21941211/WiLo/README.md

# WiLo
Full documentation of the WiLo (Wireless Logger) LoRa enabled environmental monitoring logger.
