21941211/WiLo/WiLoV2/WiLoV2 Documentation/Source/Board_Map.odp

USB-IN

POWER SWITCH

SD CARD

BATT

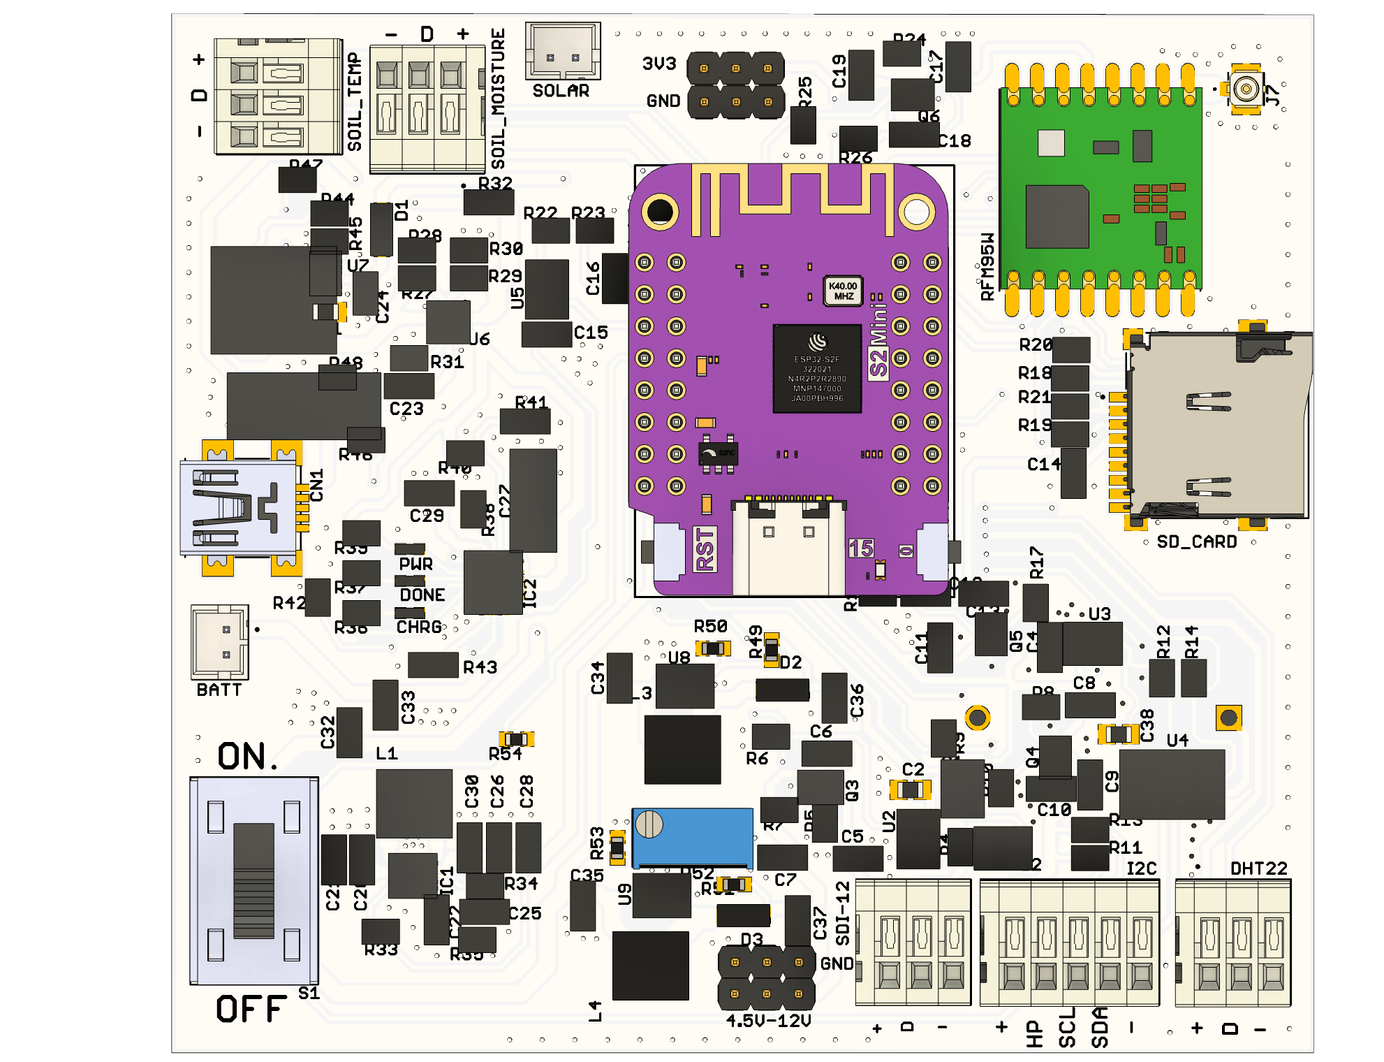
[picture p2: figure]

PORT 1

PORT 2

SOLAR

PWR 1

PORT 3

PORT 4

PORT 5

PWR 2
