21941211/WiLo/DigiDendro - I2C Digitised Dendrometer/PCB Layout/DigiDendroBottom.png

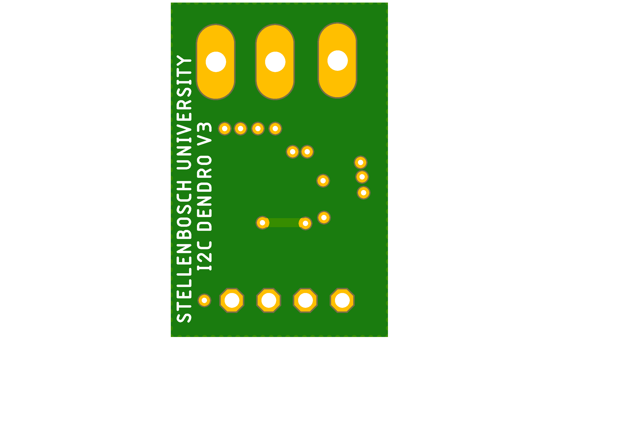
DigiDendro - I2C Digitised Dendrometer/PCB Layout/DigiDendroBottom.png
