21941211/WiLo/DigiDendro - I2C Digitised Dendrometer/PCB Layout/DigiDendroTop.png

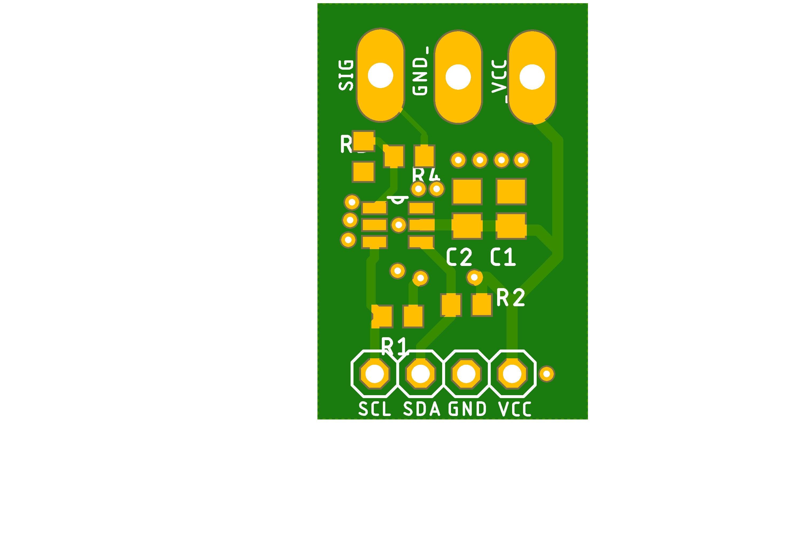
DigiDendro - I2C Digitised Dendrometer/PCB Layout/DigiDendroTop.png
