21941211/WiLo/SU_Forestry_SapFlow/Directions_for_mounting.png

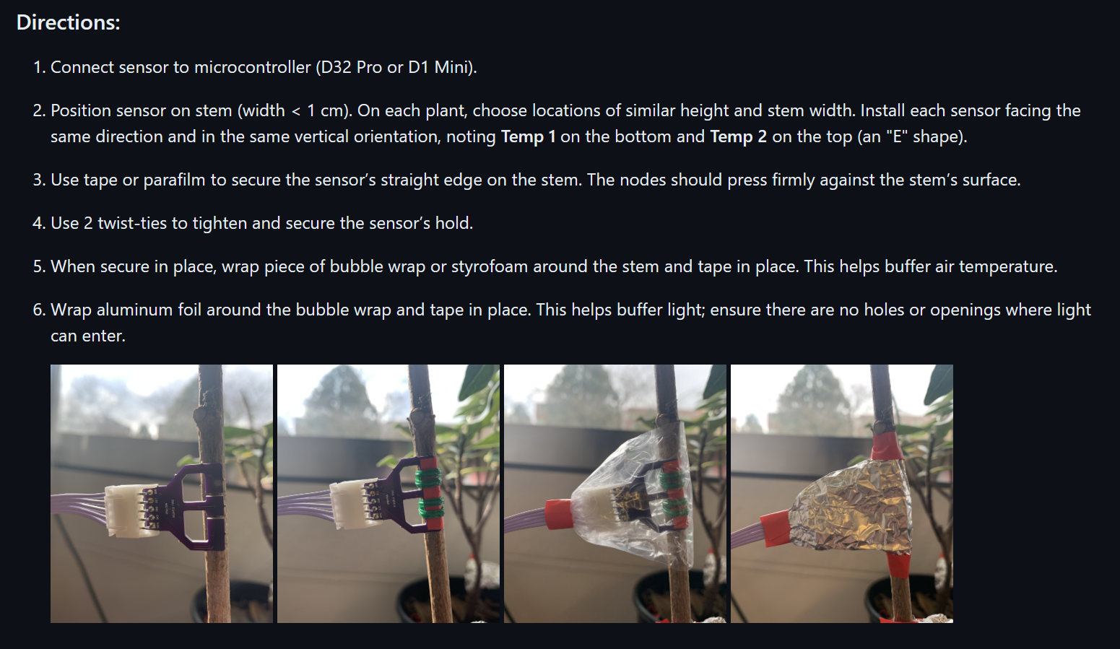
SU_Forestry_SapFlow/Directions_for_mounting.png
