21941211/WiLo/SU_Forestry_SapFlow/dotmote_labs/sapflow-master/docs/sapflow_gauge.png

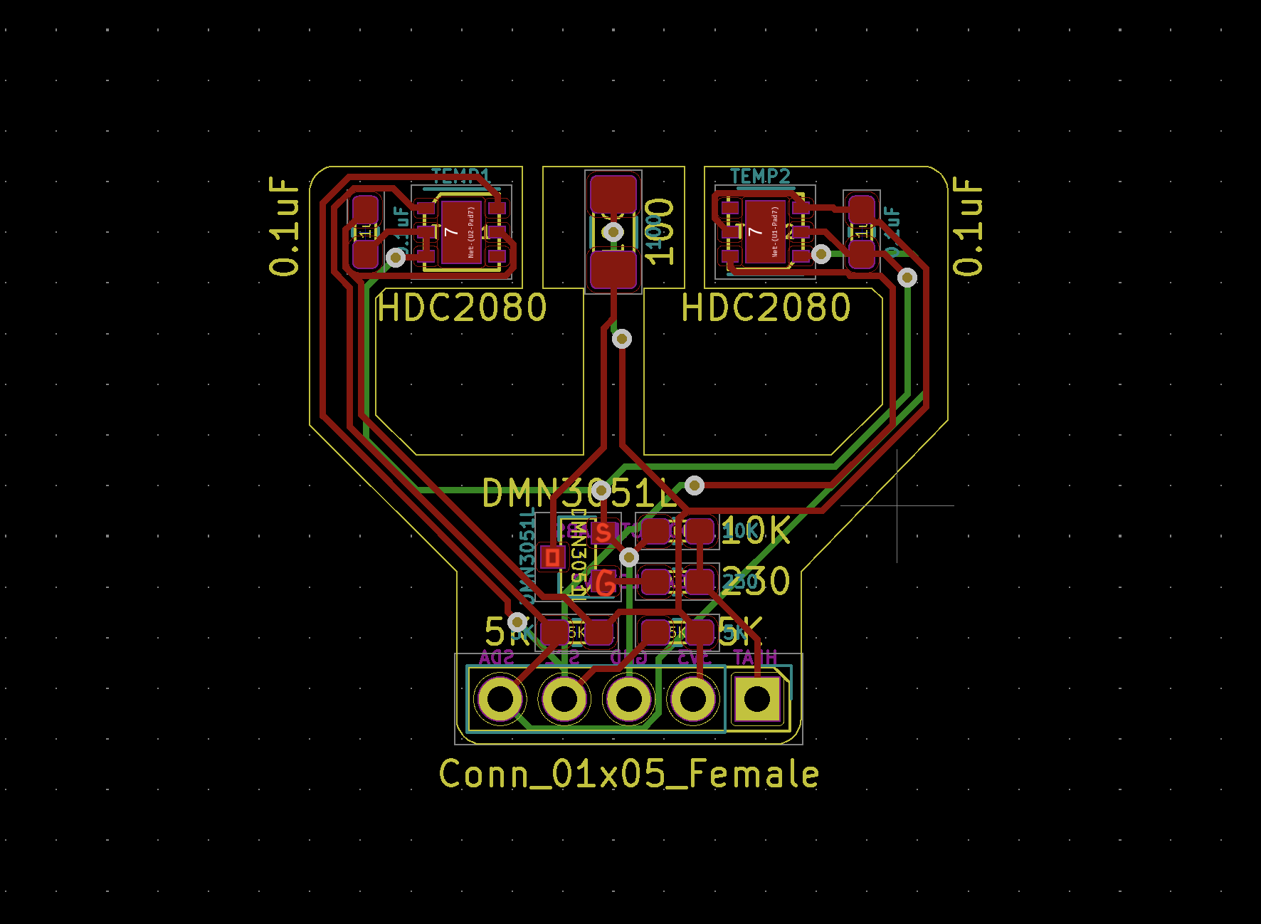
SU_Forestry_SapFlow/dotmote_labs/sapflow-master/docs/sapflow_gauge.png
