21941211/WiLo/WiLoV2/WiLoV2 Documentation/Source/PCB_Bottom.png

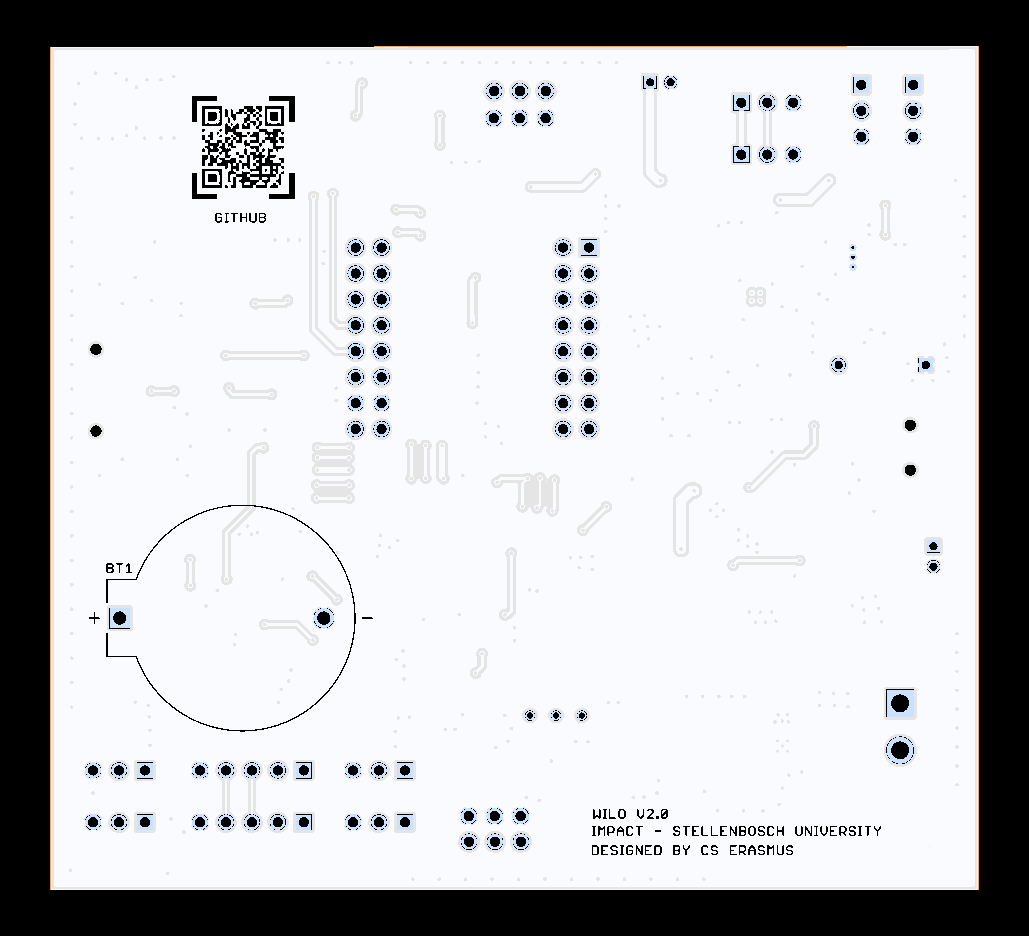
WiLoV2/WiLoV2 Documentation/Source/PCB_Bottom.png
