21941211/WiLo/WiLoV2/WiLoV2 Documentation/Source/WiLoV2_No_MCU.png

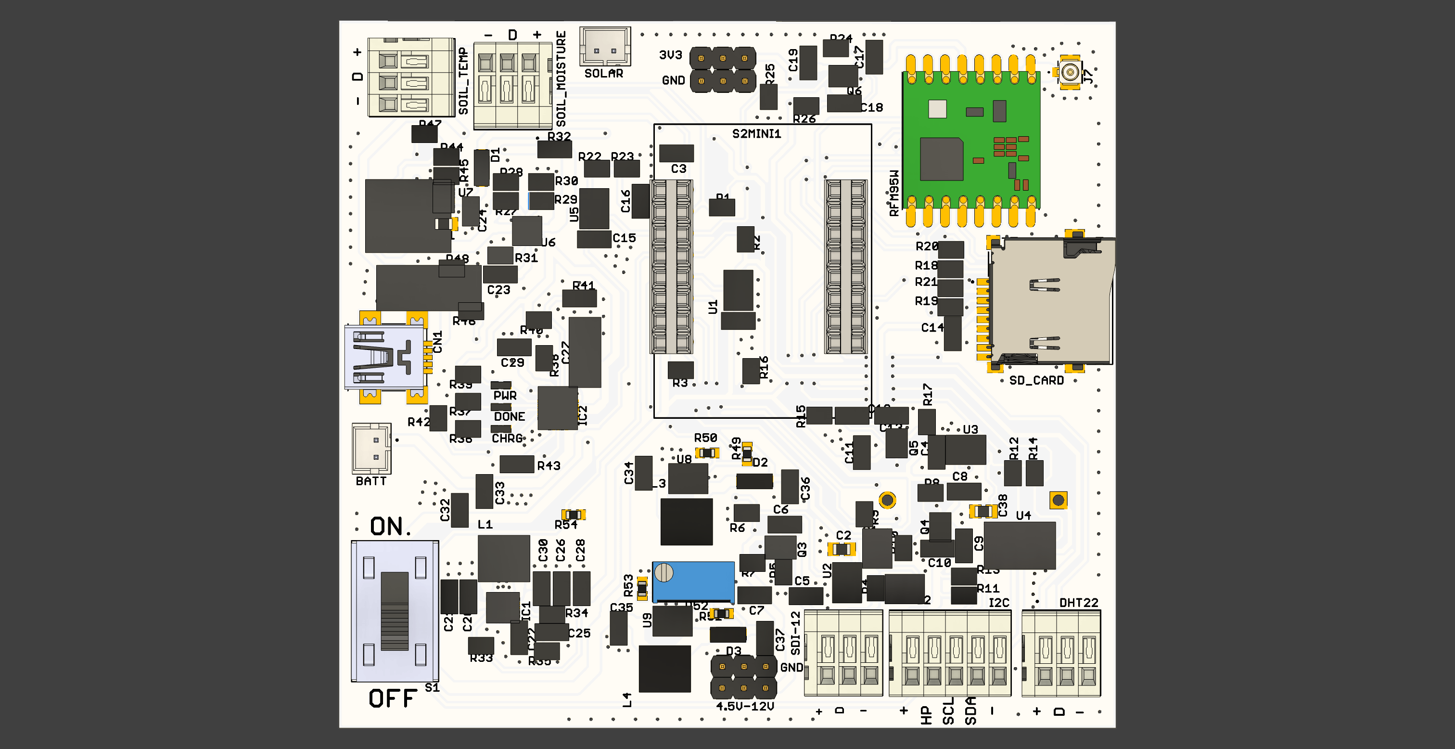
WiLoV2/WiLoV2 Documentation/Source/WiLoV2_No_MCU.png
