21941211/WiLo/SU_Forestry_SapFlow/BOM and Gerber/BOM_SapFlow.xlsx

 |  |  | xxxx xxxx xxxxx xxPCS BOM
Item # | *Designator | *Qty | Manufacturer | *Mfg Part # | Description / Value | *Package/Footprint | Type | Your Instructions / Notes
1 | 0.1uF, 0.1uF | 2 | Samsung Electro Mechanics | CL10B104KB8NNNC | 0.1 uF Capacitor (0603 Package) | 0603 | SMD | The same designator is used for the left and right of the pcb | Link (https://www.digikey.com/product-detail/en/samsung-electro-mechanics/CL10B104KB8NNNC/1276-1000-1-ND/3889086)
2 | DMN3051L | 1 | Diodes | DMN3051L-7 | DMN3051L-7 Logic Level Mosfet (SOT23 Package) | SOT23 | DNS | Only one possible orientation | Link (https://www.digikey.com/product-detail/en/diodes-incorporated/DMN3051L-7/DMN3051LDICT-ND/1964754)
4 | 5K, 5K | 2 | TE Connectivity Passive Product | CRGP0603F5K6 | 5K Ohm Resistor (0603 Package) | 0603 | SMD | The same designator is used for the left and right of the pcb | Link (https://www.digikey.com/product-detail/en/te-connectivity-passive-product/CRGP0603F5K6/A130425CT-ND/8578257)
5 | 230 | 1 | Panasonic | ERJ-3EKF2700V | 270 Ohm Resistor (0603 Package) | 0603 | SMD |  | Link (https://www.digikey.com/product-detail/en/panasonic-electronic-components/ERJ-3EKF2700V/P270HCT-ND/1746751)
6 | 10K | 1 | Stackpole Electronics Inc | RNCP0603FTD10K0 | 10K Ohm Resistor (0603 Package) | 0603 | SMD |  | Link (https://www.digikey.com/product-detail/en/stackpole-electronics-inc/RNCP0603FTD10K0/RNCP0603FTD10K0CT-ND/2240478)
7 | TEMP1,TEMP2 | 2 | Texas Instruments | HDC2080DMBT | HDC2080 Temperature & Humidity Sensor (6-WSON Package) | 6-WSON | SMD | Align package corner (underneath) with corner on footprint (see note 1 below) | Link (https://www.digikey.com/product-detail/en/texas-instruments/HDC2080DMBT/296-49482-1-ND/9360700)
8 | 100 | 1 | Stackpole Electronics Inc | RNCP1206FTD100R | 100 Ohm Resistor (1206 Package) | 1206 | SMD |  | Link (https://www.digikey.com/product-detail/en/stackpole-electronics-inc/RNCP1206FTD100R/RNCP1206FTD100RCT-ND/2240655)
Need a quick and accurante quote? Need an efficient production? Please read SMT Ordering Necessary Files & Info in 1 minute. Thank you very much! (https://www.pcbway.com/smt_ordering_guide.html)
Click for Instructions on How to Create a BOM (https://www.pcbway.com/blog/PCB_Assembly/How_to_Build_a_BOM__Bill_Of_Materials_.html)
 |  |  |  |  | Note 1
