21941211/WiLo/SU_Forestry_SapFlow/BOM and Gerber/Copy of T-1N8W740357A-250sets-BOM_SapFlow(2025-02-02).xls

PCBWay Bom Quotation, Product No.:T-1N8W740357A
Item # | *Designator | *Qty | Manufacturer | *Mfg Part # | Description / Value | *Package/Footprint | Mounting Type | Your Instructions / Notes | *Unit Price(250 sets) | *Total | *Delivery Time | *PCBWay Note | Customer Reply | PCBWay Update
1 | 0.1uF, 0.1uF | 2 | Samsung Electro Mechanics | CL10B104KB8NNNC | 0.1 uF Capacitor (0603 Package) | 0603 | SMD | The same designator is used for the left and right of the pcb『 』Link | $0.004 | $2.000 |  | Reference designator [0.1uF] is duplicated, please confirm. | Correct, both designators have a 0.1uF Cap
2 | DMN3051L | 1 | Diodes | DMN3051L-7 | DMN3051L-7 Logic Level Mosfet (SOT23 Package) | SOT23 | SMD | Only one possible orientation『 』Link |  |  |  | [DNP不要贴]; | Please add, should be soldered onto the boards.
3 | 5.6K, 5.6K | 2 | TE Connectivity Passive Product | CRGP0603F5K6 | 5K Ohm Resistor (0603 Package) | 0603 | SMD | The same designator is used for the left and right of the pcb『 』Link | $0.009 | $4.500 |  | The correct resistance value for the listed Part Number [CRGP0603F5K6] is indeed [5.6], not [5KΩ].Please confirm.; Reference designator [5K] is duplicated, please confirm. | This is indeed correct, 5.6k is fine.
4 | 230 | 1 | Panasonic | ERJ-3EKF2700V | 270 Ohm Resistor (0603 Package) | 0603 | SMD | Link | $0.009 | $2.250
5 | 10K | 1 | Stackpole Electronics Inc | RNCP0603FTD10K0 | 10K Ohm Resistor (0603 Package) | 0603 | SMD | Link | $0.031 | $7.750 | 7-10 Workdays
6 | TEMP1,TEMP2 | 2 | Texas Instruments | HDC2080DMBT | HDC2080 Temperature & Humidity Sensor (6-WSON Package) | 6-WSON | SMD | Align package corner (underneath) with corner on footprint (see note 1 below)『 』Link | $3.401 | $1700.500 | 7-10 Workdays
7 | 100 | 1 | Stackpole Electronics Inc | RNCP1206FTD100R | 100 Ohm Resistor (1206 Package) | 1206 | SMD | Link | $0.041 | $10.250
 |  |  |  |  |  |  |  |  | Component Cost | $1727.25
 |  |  |  |  |  |  |  |  | Assembly Cost | $304.29
 |  |  |  |  |  |  |  |  | PCB Cost | $57.97
 |  |  |  |  |  |  |  |  | V3 Member 3% off | -$10.87
 |  |  |  |  |  |  |  |  | All Total 250 Sets | $2078.64
