21941211/WiLo/3D printing/Fusion 360/PCB Clip/Source/PCB_Mount.FCStd

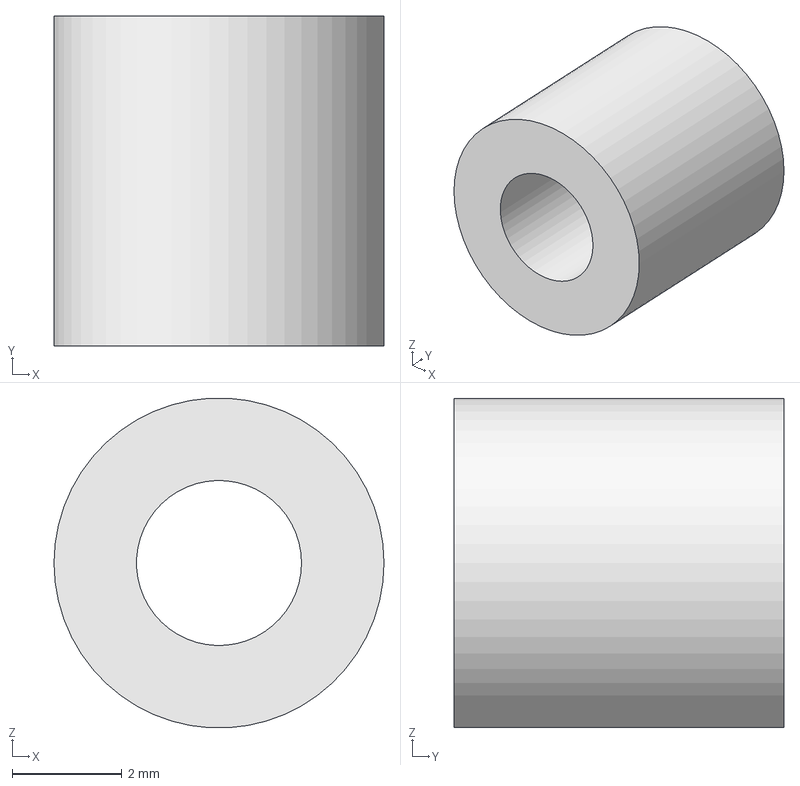
[picture p11: CAD file, 2025-04-16]
3D printing/Fusion 360/PCB Clip/Source/PCB_Mount.FCStd
6.00 x 6.00 x 5.99 mm
