21941211/WiLo/3D printing/STLs/DHT22 Stevenson Screen/Mount.stl

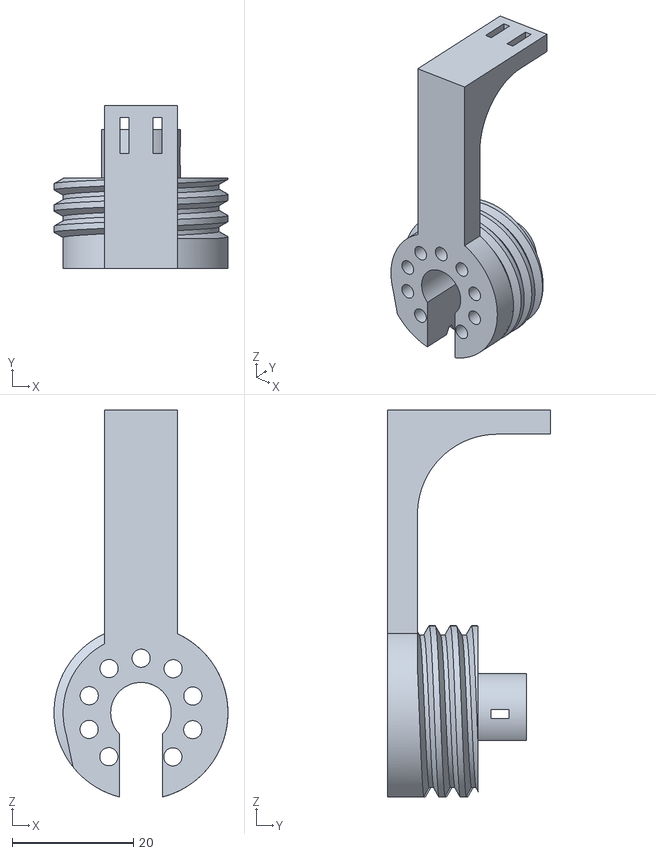
[picture p12: CAD file, 2025-04-16]
3D printing/STLs/DHT22 Stevenson Screen/Mount.stl
28.7 x 27.0 x 63.9
