21941211/WiLo/3D printing/STLs/PCB Clips/PCB Clip Right Side.stl

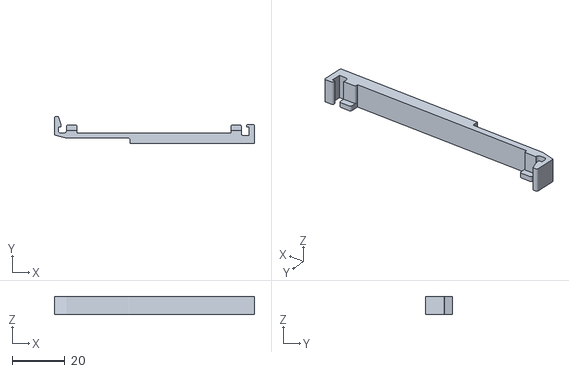
[picture p13: CAD file, 2025-04-16]
3D printing/STLs/PCB Clips/PCB Clip Right Side.stl
75.8 x 10.2 x 7.00
