21941211/WiLo/Battery Charger Files/Power supply and charger module hub bracket.stl

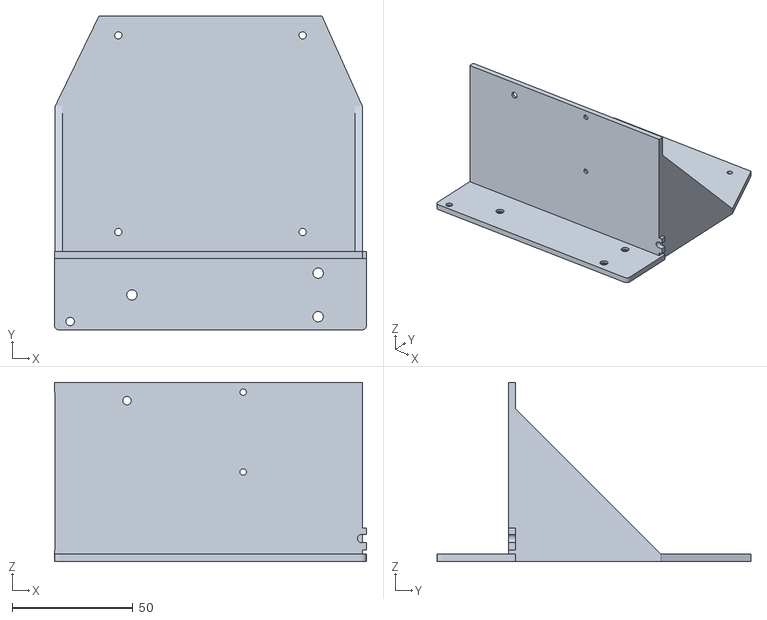
[picture p14: CAD file, 2025-07-03]
Battery Charger Files/Power supply and charger module hub bracket.stl
129.0 x 129.8 x 74.0
