21941211/WiLo/3D printing/STLs/DHT22 Stevenson Screen/Screen.stl

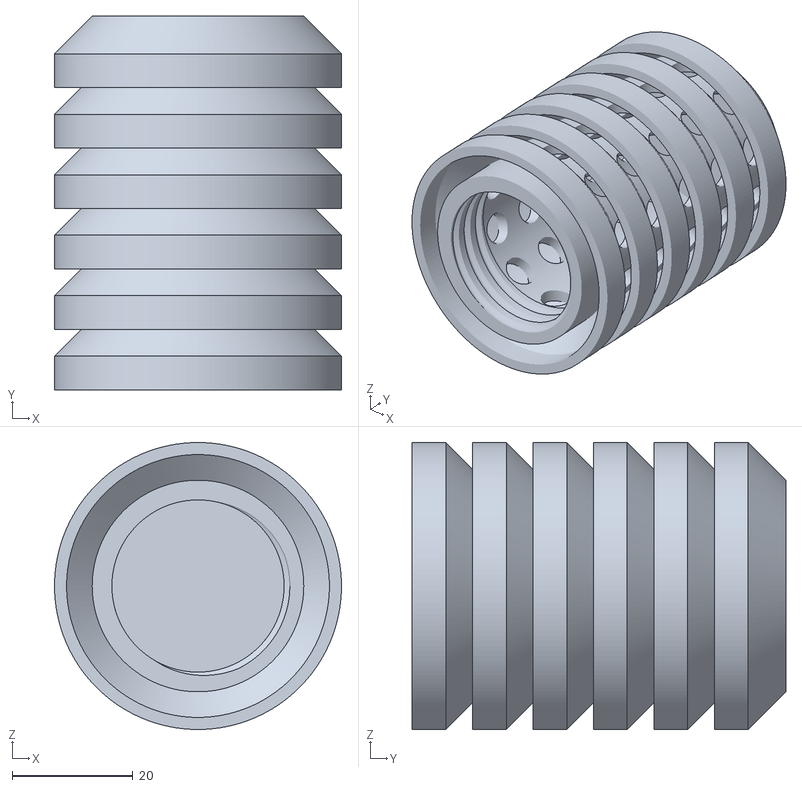
[picture p16: CAD file, 2025-04-16]
3D printing/STLs/DHT22 Stevenson Screen/Screen.stl
47.5 x 61.8 x 47.5
