21941211/WiLo/(list of files, cad)

Other CAD files:
3D printing/Fusion 360/PCB Clip/PCB_CLip_WiLo_V1 v1.f3d
3D printing/Fusion 360/PCB Clip/Source/PCB_Clip v19.f3d
Battery Charger Files/WiLoV2 v2.f3d
