21941211/WiLo/3D printing/STLs/Ball and socket joint for solar panel/README.MD

This is a ball and socket joint that we haven't used for the WiLos yet, but will be a nice addition. Credit to the creator at: https://www.thingiverse.com/thing:67911

Print settings:
    - Material: PETG (Stronger than PLA. PLA+ or ABS might work too.)
    - Infill: 100%
    - Supports: None
    - Print temperature: 235 C
    - Build Plate Temperature: 85 C
    - Layer Height : 0.2mm
