21941211/WiLo/3D printing/Fusion 360/PCB Clip/Source/README.md

# PCB-Mount
A Fusion 360 and FreeCAD project file that contains two bodies to mount PCBs: a simple spacer cylinder for classic screw mounts of PCBs and the RAYDIY's hipster PCB-Clips.

Use with FreeCAD version 0.19.23576 or newer. I had problems with versions prior to this one.

YouTube Video with introduction (in german)
- https://youtu.be/MF4QiW3_oBQ

Blog Article (in german)
- https://raydiy.de/clippen-statt-schrauben-microcontroller-befestigen-mit-pcb-clips/
