21941211/WiLo/SU_Forestry_SapFlow/dotmote_labs/sapflow-master/InstallationSteps_full.md

# Installation Steps
1. [Sensor Installation](#sensorinstallation)
2. [Checklist for D32 Pro (WiFi)](#d32wifi)
3. [Checklist for D32 Pro (Raspberry Pi)](#d32pi)
4. [Checklist for D1 Mini](#d1mini)

-------------------------------

<a href="#top">(Back to top)</a>  

## Sensor Installation                                                  

### Materials: 
* Sensor
* Tape or parafilm
* 2 Twist-ties
* Bubble wrap or styrofoam (~ 5 x 12 cm)
* Aluminum foil (~ 5 x 12 cm)

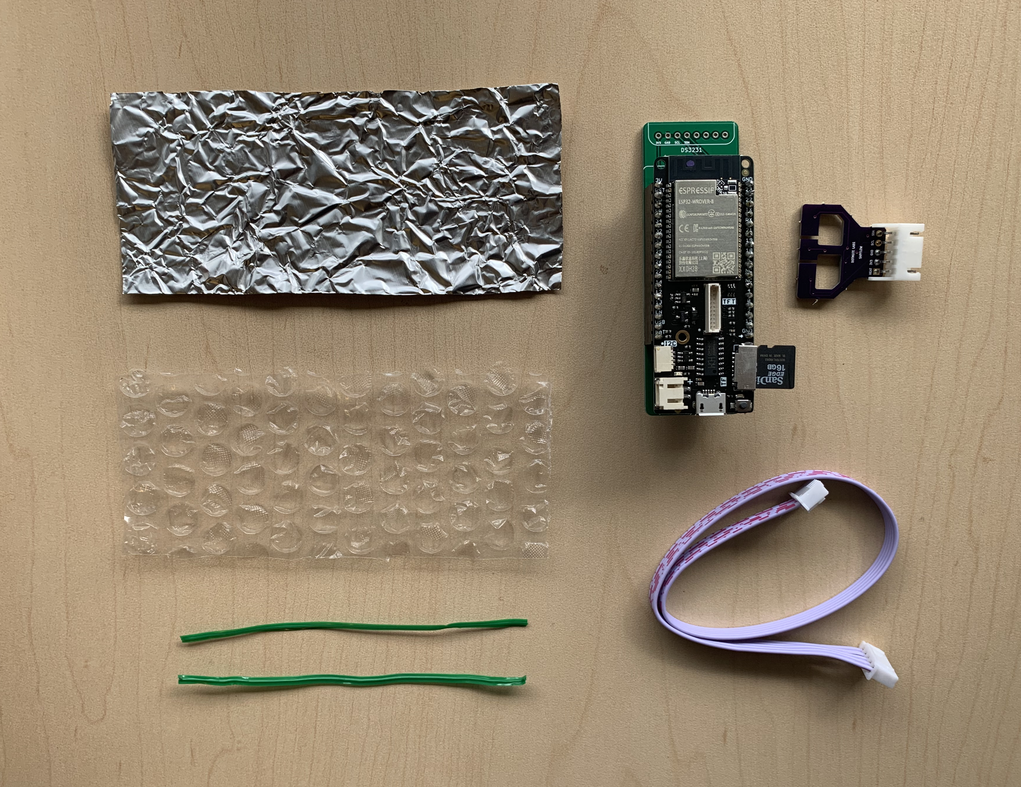
[picture p17: SU_Forestry_SapFlow/dotmote_labs/sapflow-master/docs/InstallationMaterials.png]


### Directions:
1. Connect sensor to microcontroller (D32 Pro or D1 Mini).
2. Position sensor on stem (width < 1 cm). On each plant, choose locations of similar height and stem width. Install each sensor facing the same direction and in the same vertical orientation, noting **Temp 1** on the bottom and **Temp 2** on the top (an "E" shape). 
3. Use tape or parafilm to secure the sensor’s straight edge on the stem. The nodes should press firmly against the stem’s surface. 
4. Use 2 twist-ties to tighten and secure the sensor’s hold.
5. When secure in place, wrap piece of bubble wrap or styrofoam around the stem and tape in place. This helps buffer air temperature.
6. Wrap aluminum foil around the bubble wrap and tape in place. This helps buffer light; ensure there are no holes or openings where light can enter. 

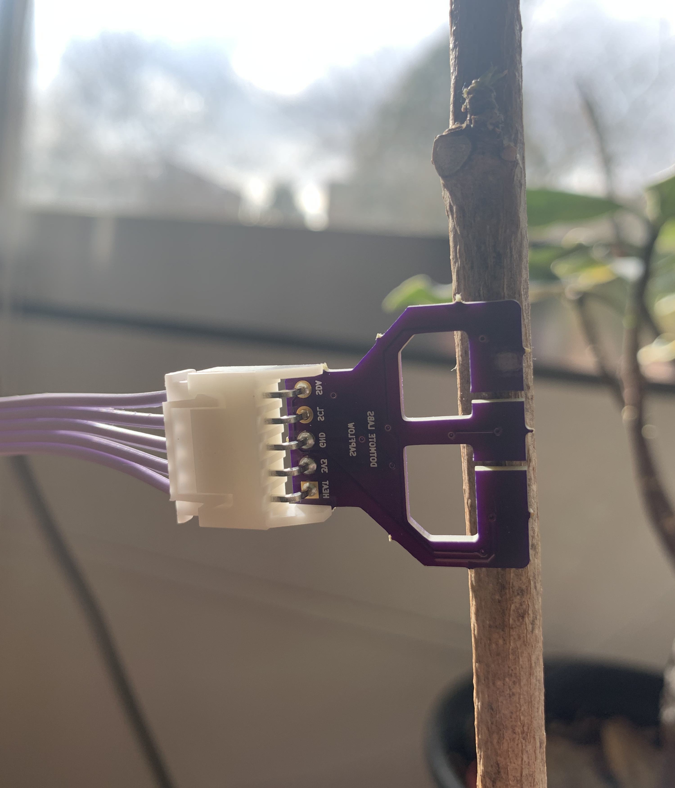
[picture p18: SU_Forestry_SapFlow/dotmote_labs/sapflow-master/docs/InstallationSensor1.png]
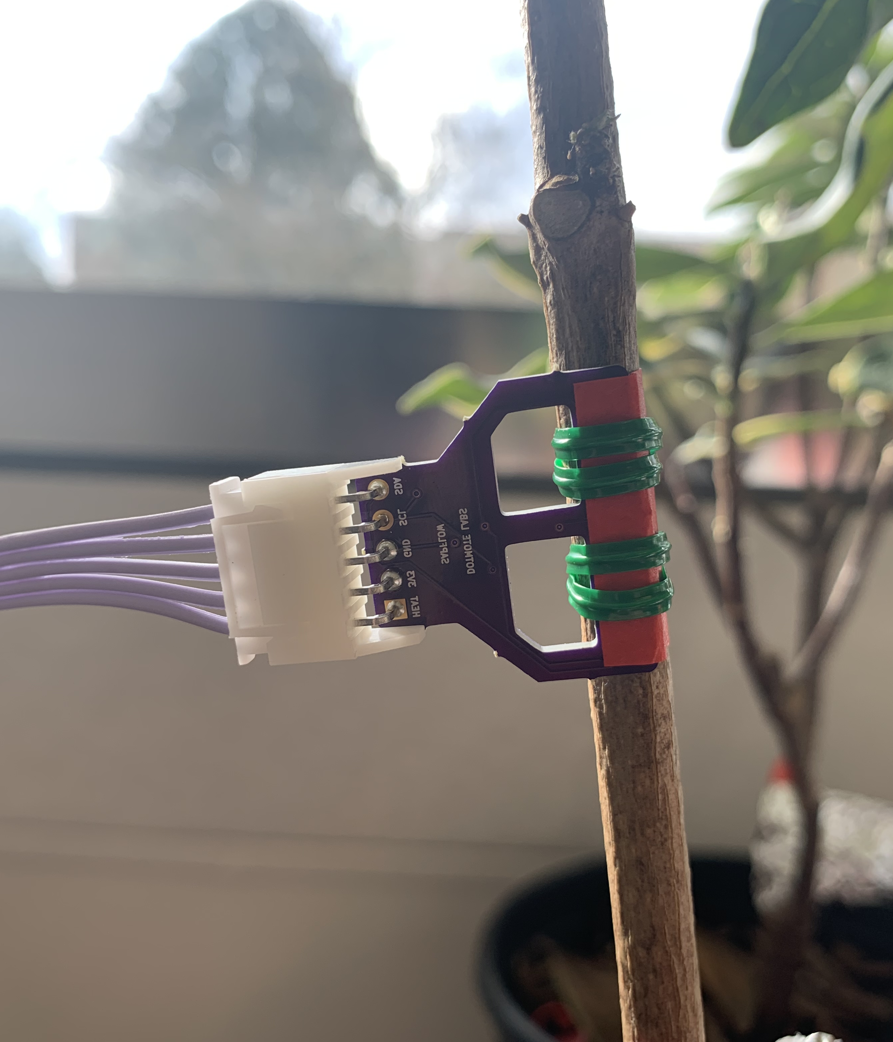
[picture p19: SU_Forestry_SapFlow/dotmote_labs/sapflow-master/docs/InstallationSensor2.png]
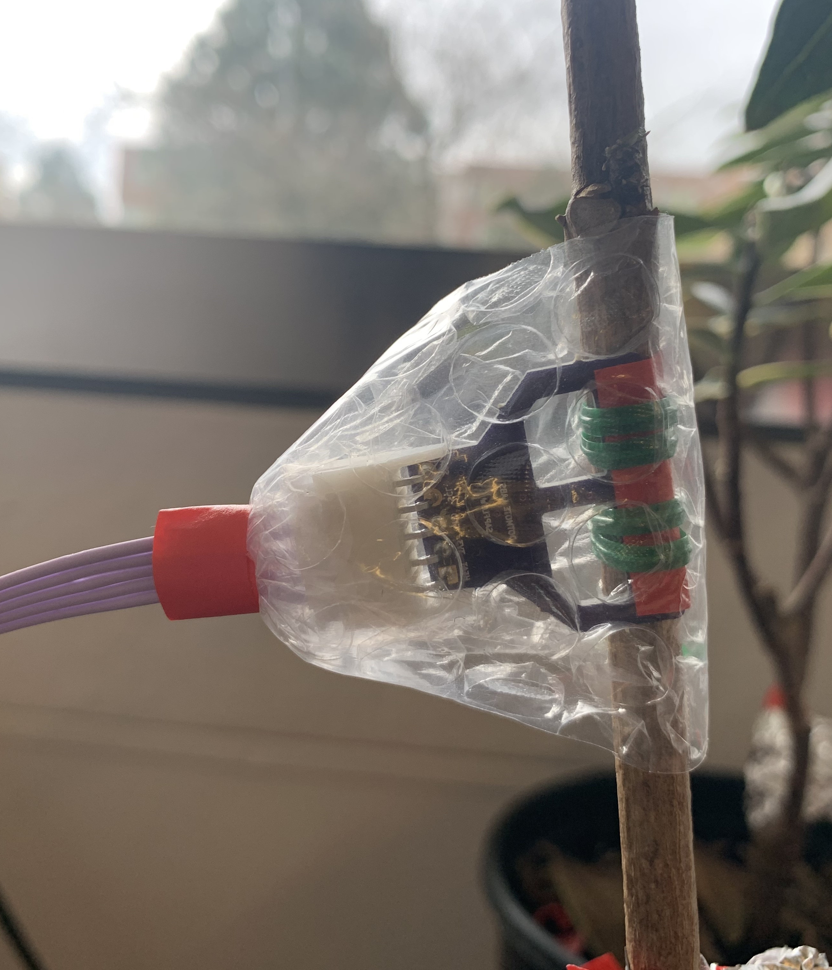
[picture p20: SU_Forestry_SapFlow/dotmote_labs/sapflow-master/docs/InstallationSensor3.png]
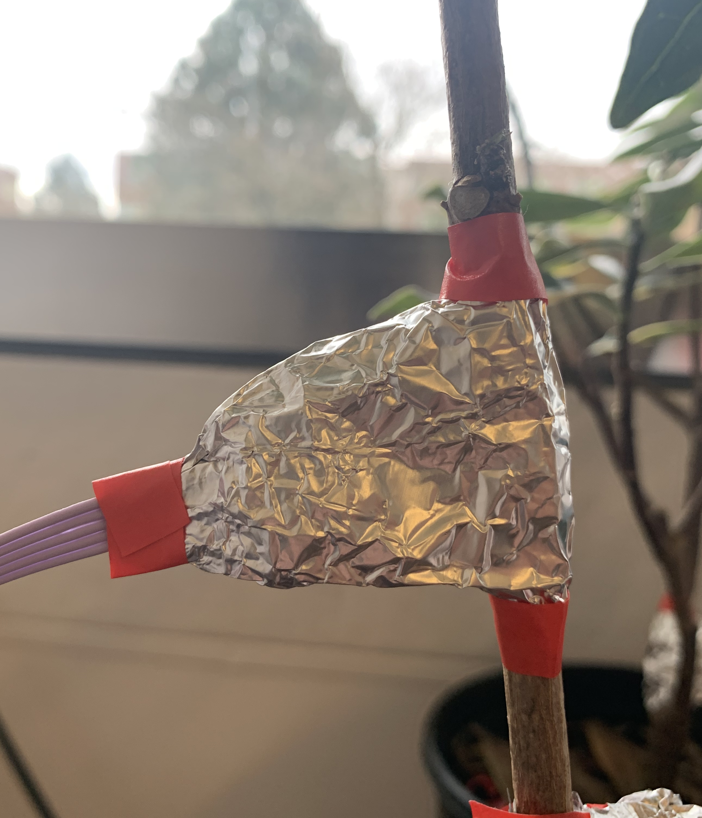
[picture p21: SU_Forestry_SapFlow/dotmote_labs/sapflow-master/docs/InstallationSensor4.png]
      

-------------------------------

<a href="#top">(Back to top)</a> 

## Checklist for D32 Pro (WiFi) 

### Board: [Arduino-ESP32](https://github.com/espressif/arduino-esp32/blob/master/docs/arduino-ide/boards_manager.md)
- [ ] Connect microcontroller via USB.
- [ ] In Arduino, open Preferences and copy release link to Additional Boards Manager URLs. Separate multiple URLs with commas. (Files > Preferences)
- [ ] Open Boards Manager, search **"esp32"** and install. (Tools > Board > Boards Manager)
- [ ] Switch board to **LOLIN D32 PRO**. (Tools > Board)

### Install dependencies:
- [ ] In Library Manager, search and install the following libraries (Tools > Manage Libraries):
    - [Adafruit GFX](https://github.com/adafruit/Adafruit-GFX-Library)
    - [ArduinoJSON](https://arduinojson.org/) by Benoit Blanchon
    - [ESP_DoubleResetDetector](https://github.com/khoih-prog/ESP_DoubleResetDetector) by Khoi Hoang
    - [ESP_WiFiManager](https://github.com/khoih-prog/ESP_WiFiManager) by Khoi Hoang
    - [HDC2080 Arduino Library](https://github.com/lime-labs/HDC2080-Arduino) by Lime Labs
    - [PubSubClient](https://pubsubclient.knolleary.net/) by Nick O'Leary
    - [RTC by Makuna](https://github.com/Makuna/Rtc/wiki) by Michael C. Miller
    - [Time](https://playground.arduino.cc/code/time/) by Michael Margolis
- [ ] These optional libraries can be downloaded online and copied to Arduino Libraries folder in Finder. Comment out applicable lines in script if unused. (In Finder, Arduino > libraries)
    - [LOLIN E-Paper Display Library](https://github.com/wemos/LOLIN_EPD_Library)
    - [WEMOS SHT3x Arduino Library](https://github.com/wemos/WEMOS_SHT3x_Arduino_Library)

### Network settings:
- [ ] Open [D32 Pro script (WiFi)](https://github.com/dotmote/sapflow-usda-6/blob/master/sapflow-usda-6.ino) in Arduino.
- [ ] Verify/Compile and Upload to microcontroller via USB
- [ ] Connect to WiFi: 
    - On phone or computer, select WiFi network **“SAPFLOW_<unique_chip_id>”**. 
    - On next screen, select **“Configuration”**.
    - Select WiFi network, enter password, and select **"Save"**.
    - Wait to connect. “SAPFLOW_<unique_chip_id>” will disappear from network list when complete.
- [ ] NOTES:
    - Once connected, the "SAPFLOW_<unique_chip_id>" network will not reappear when reconnecting to the same network. 
    - If "SAPFLOW_<unique_chip_id>" network does not appear for initial connection, press and hold Reset button on microcontroller for 5 seconds. 
    - The microcontroller might reset itself while attempting to connect to the network.
    
### Check:
- [ ] Operating modes:
    - **Normal:** If microcontroller is successfully connected to the network, the blue LED will be solid only during the heat pulse. Data will be both recorded to the MicroSD card and uploaded online through the dashboard.
    - **Offline:** If microcontroller is in offline mode, the blue LED will blink continuously (~1 blink/second). Data will only be recorded to the MicroSD card.
- [ ] Sign into the [Sapflow Dashboard](https://www.dotmote.com/) to check that data is uploading.

-------------------------------

<a href="#top">(Back to top)</a> 

## Checklist for D32 Pro (Raspberry Pi) 

### Board: [Arduino-ESP32](https://github.com/espressif/arduino-esp32/blob/master/docs/arduino-ide/boards_manager.md)
- [ ] Connect microcontroller via USB.
- [ ] In Arduino, open Preferences and copy release link to Additional Boards Manager URLs. Separate multiple URLs with commas. (Files > Preferences)
- [ ] Open Boards Manager, search **"esp32"** and install. (Tools > Board > Boards Manager)
- [ ] Switch board to **LOLIN D32 PRO**. (Tools > Board)

### Install dependencies:
- [ ] In Library Manager, search and install the following libraries (Tools > Manage Libraries):
    - [Adafruit GFX](https://github.com/adafruit/Adafruit-GFX-Library)
    - [ArduinoJSON](https://arduinojson.org/) by Benoit Blanchon
    - [HDC2080 Arduino Library](https://github.com/lime-labs/HDC2080-Arduino) by Lime Labs
    - [PubSubClient](https://pubsubclient.knolleary.net/) by Nick O'Leary
    - [RTC by Makuna](https://github.com/Makuna/Rtc/wiki) by Michael C. Miller
- [ ] These optional libraries can be downloaded online and copied to Arduino Libraries folder in Finder. Comment out applicable lines in script if unused. (In Finder, Arduino > libraries)
    - [LOLIN E-Paper Display Library](https://github.com/wemos/LOLIN_EPD_Library)
    - [WEMOS SHT3x Arduino Library](https://github.com/wemos/WEMOS_SHT3x_Arduino_Library)
- [ ] NOTE: For PubSubClient, edit PubSubClient.h increase max packet size from **128b to 512b**.
(In Finder, Arduino > libraries > PubSubClient > src > PubSubClient.h > Edit **“#define MQTT_MAX_PACKET_SIZE 512”**)

### Network settings:
- [ ] Open [D32 Pro script (Pi)](https://github.com/dotmote/sapflow/blob/master/software/microcontroller/d32_pro/d32_pro_sapflow_mqtt_sd/d32_pro_sapflow_mqtt_sd.ino) in Arduino. (If microcontroller doesn't have an RTC chip, open [D32 Pro script (no RTC)](https://github.com/dotmote/sapflow/blob/master/software/microcontroller/d32_pro/d32_pro_sapflow_mqtt_noRtc/d32_pro_sapflow_mqtt_noRtc.ino).)
- [ ] ClientID: change `“clientID”`
- [ ] Server/broker IP address: change `“mqtt_server”`
- [ ] Connect to WiFi: enter `“wifi name”` and `“wifi password”`
- [ ] Verify/Compile and Upload to microcontroller via USB

### Check:
- [ ] Open Serial Monitor and check that data is uploading. (Tools > Serial Monitor)
- [ ] Check that Temperatures are not reading negative. If yes, try pressing Reset button on microcontroller several times.
- [ ] Check that data is also transmitting on Raspberry Pi.

-------------------------------

<a href="#top">(Back to top)</a> 

## Checklist for D1 Mini 

### Board: [Arduino-ESP8266](https://github.com/esp8266/Arduino)
- [ ] Connect microcontroller via USB.
- [ ] In Arduino, open Preferences and copy release link (https://arduino.esp8266.com/stable/package_esp8266com_index.json) to Additional Boards Manager URLs. Separate multiple URLs with commas. (Files > Preferences)
- [ ] Open Boards Manager, search **"esp8266"** and install. (Tools > Board > Boards Manager)
- [ ] Switch board to **LOLIN (WEMOS) D1 mini Lite**. (Tools > Board)

### Install dependencies:
- [ ] In Library Manager, search and install the following libraries (Tools > Manage Libraries):
    - [ArduinoJSON](https://arduinojson.org/) by Benoit Blanchon
    - [HDC2080 Arduino Library](https://github.com/lime-labs/HDC2080-Arduino) by Lime Labs
    - [PubSubClient](https://pubsubclient.knolleary.net/) by Nick O'Leary
    - [WiFi Manager](https://github.com/tzapu/WiFiManager) by Tzapu
- [ ] This optional library can be downloaded online and copied to Arduino Libraries folder in Finder. Comment out applicable lines in script if unused. (In Finder, Arduino > libraries)
    - [WEMOS SHT3x Arduino Library](https://github.com/wemos/WEMOS_SHT3x_Arduino_Library)
- [ ] NOTE: For PubSubClient, edit PubSubClient.h increase max packet size from **128b to 512b**.
(In Finder, Arduino > libraries > PubSubClient > src > PubSubClient.h > Edit **“#define MQTT_MAX_PACKET_SIZE 512”**)

### Network settings:
- [ ] Open [D1 Mini script](https://github.com/dotmote/sapflow/blob/master/software/microcontroller/d1_mini/d1_mini_sapflow_mqtt/d1_hdc2080_sapflow_mqtt.ino) in Arduino. 
- [ ] ClientID: change `“clientID”`
- [ ] Server/broker IP address: change `“mqtt_server”`
- [ ] Verify/Compile and Upload to microcontroller via USB
- [ ] Connect to WiFi: 
    - On phone, select WiFi network **“AutoConnectAP”**. 
    - On next screen, select **“Configure WiFi”**.
    - Select WiFi network, enter password, and select **"Save"**.
    - Wait to connect. “AutoConnectAP” will disappear from network list when complete.
- [ ] NOTE: If "AutoConnectAP" network does not appear:
    - Once connected, it will not reappear when reconnecting to the same network.
    - Press and hold Reset button on microcontroller for 5 seconds. 
    - In script, activate `//wifiManager.resetSettings();` to `wifiManager.resetSettings();`. Upload to microcontroller.
    - "AutoConnectAP" network should now appear. Connect through phone.
    - In script, re-comment out `wifiManager.resetSettings();` to `//wifiManager.resetSettings();`. Re-upload to microcontroller.

### Check:
- [ ] Open Serial Monitor and check that data is uploading. (Tools > Serial Monitor)
- [ ] Check that Temperatures are not reading negative. If yes, try pressing Reset button on microcontroller several times.
- [ ] Check that data is also transmitting on Raspberry Pi.
