21941211/WiLo/WiLoV2/WiLoV2 Documentation/Source/OTA_Steps/1. Press_Add_network.jpeg

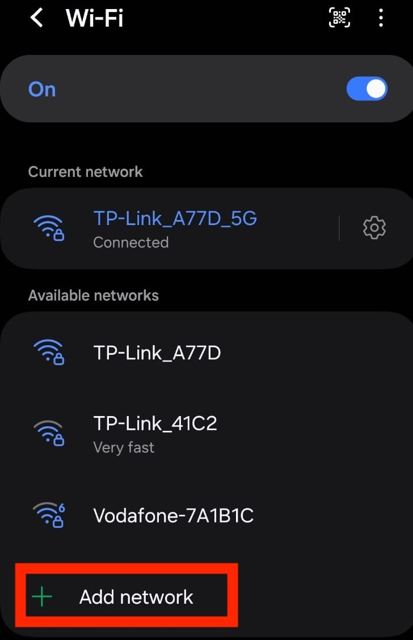
WiLoV2/WiLoV2 Documentation/Source/OTA_Steps/1. Press_Add_network.jpeg
