21941211/WiLo/WiLoV2/WiLoV2 Documentation/Source/OTA_Steps/2. Enter_Details.jpeg

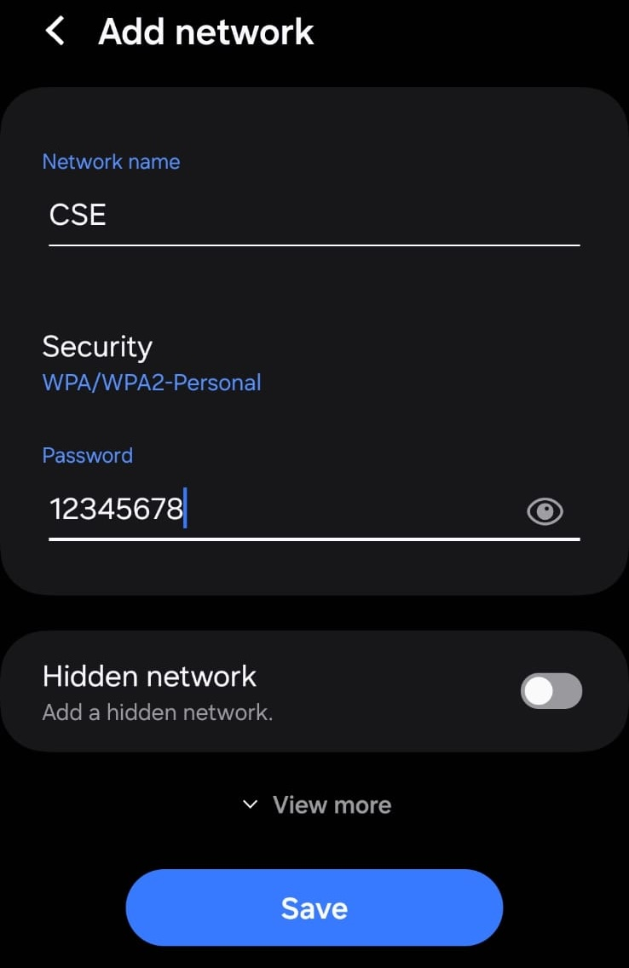
WiLoV2/WiLoV2 Documentation/Source/OTA_Steps/2. Enter_Details.jpeg
