21941211/WiLo/WiLoV2/WiLoV2 Documentation/Source/OTA_Steps/3. Select_Always_Connect.jpeg

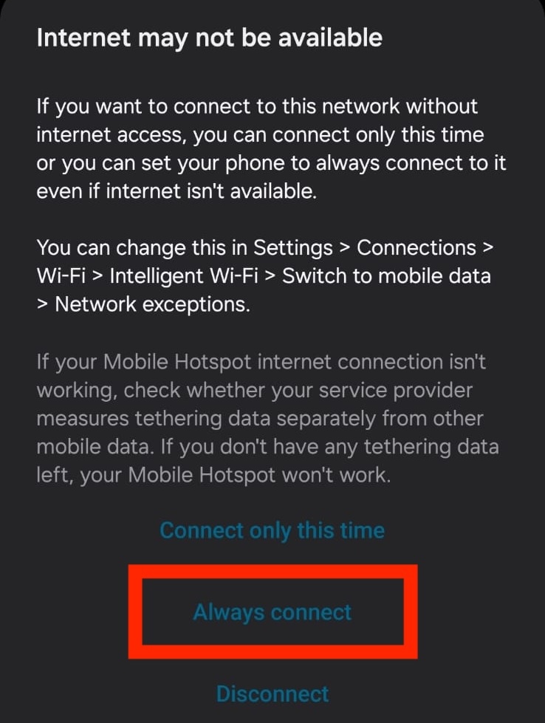
WiLoV2/WiLoV2 Documentation/Source/OTA_Steps/3. Select_Always_Connect.jpeg
