21941211/WiLo/WiLoV2/WiLoV2 Documentation/Source/OTA_Steps/4. After Accepting.jpeg

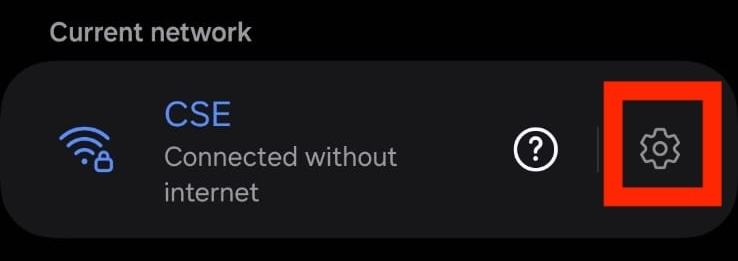
WiLoV2/WiLoV2 Documentation/Source/OTA_Steps/4. After Accepting.jpeg
