21941211/WiLo/WiLoV2/WiLoV2 Documentation/Source/OTA_Steps/5. Click Manage Router.jpeg

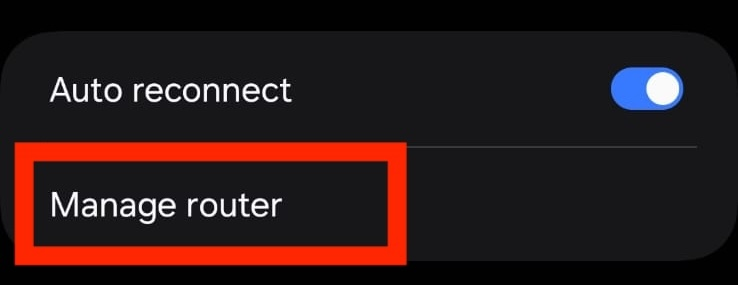
WiLoV2/WiLoV2 Documentation/Source/OTA_Steps/5. Click Manage Router.jpeg
