21941211/WiLo/WiLoV2/WiLoV2 Documentation/Source/OTA_Steps/6. Before Syncing-RTC_WiLo_Homepage.jpeg

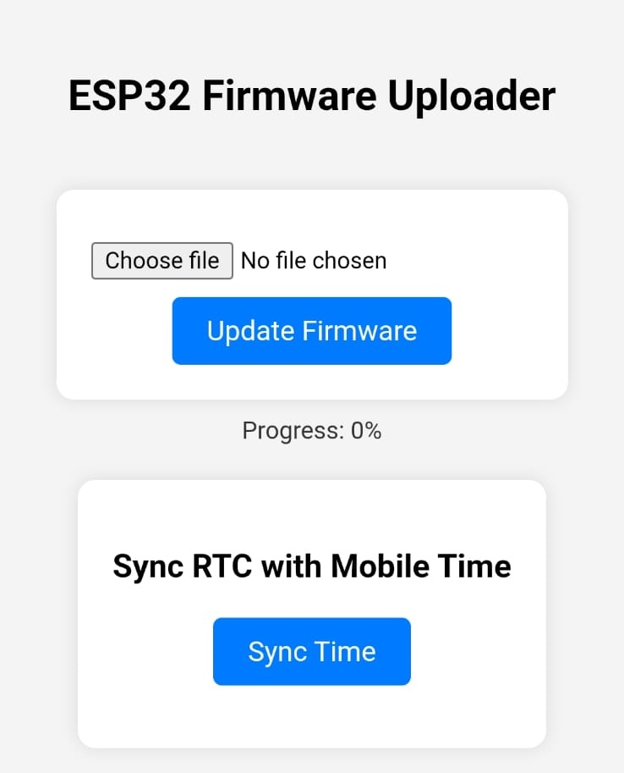
WiLoV2/WiLoV2 Documentation/Source/OTA_Steps/6. Before Syncing-RTC_WiLo_Homepage.jpeg
