21941211/WiLo/WiLoV2/WiLoV2 Documentation/Source/OTA_Steps/7. After_Syncing_RTC.jpeg

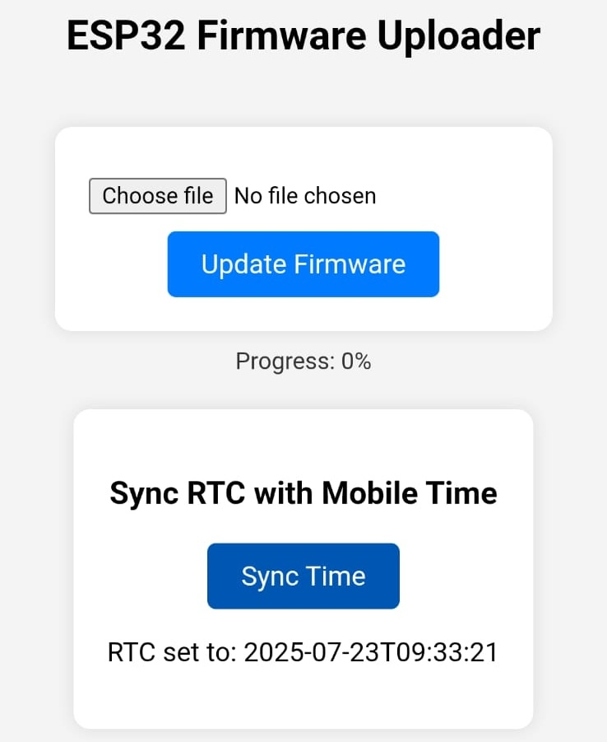
WiLoV2/WiLoV2 Documentation/Source/OTA_Steps/7. After_Syncing_RTC.jpeg
