21941211/WiLo/WiLoV2/WiLoV2 Documentation/Source/TTN_Add_WiLo_And_Application_Steps/2. Add end device .png

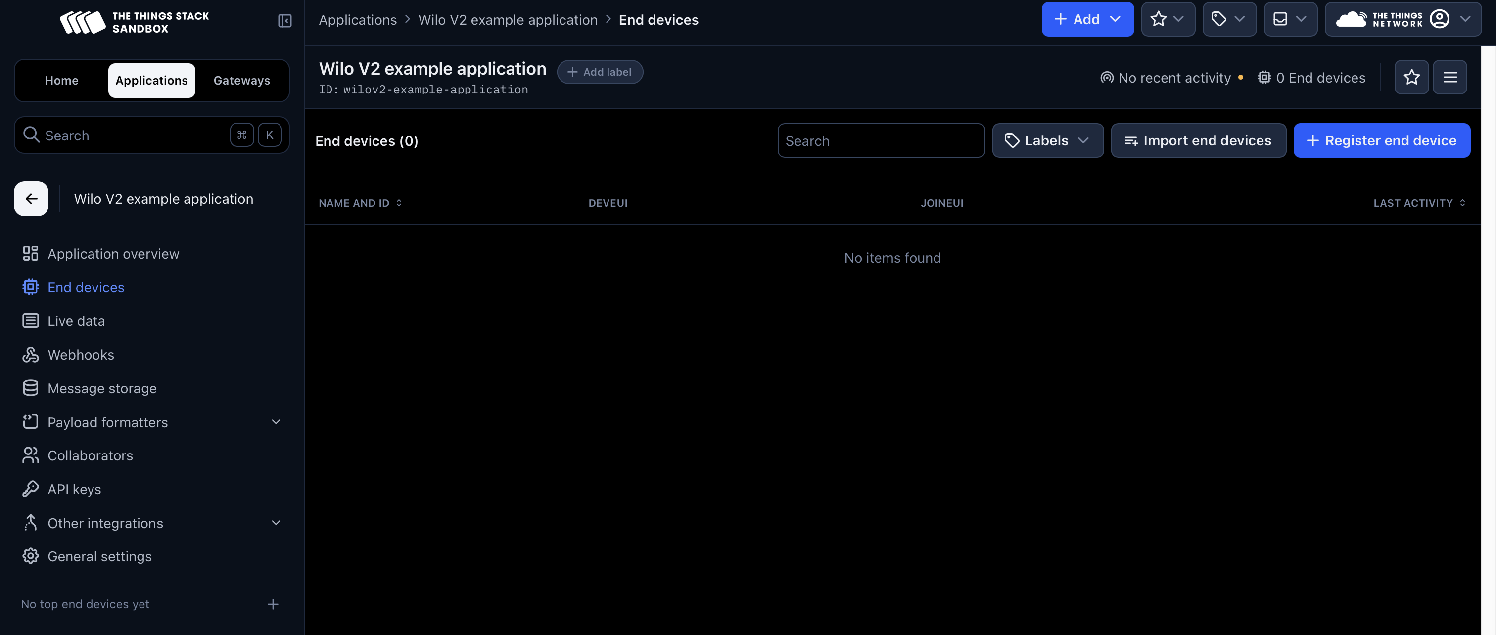
WiLoV2/WiLoV2 Documentation/Source/TTN_Add_WiLo_And_Application_Steps/2. Add end device .png
