21941211/WiLo/WiLoV2/WiLoV2 Documentation/Source/TTN_Add_WiLo_And_Application_Steps/Screenshot 2025-07-23 at 10.33.04.png

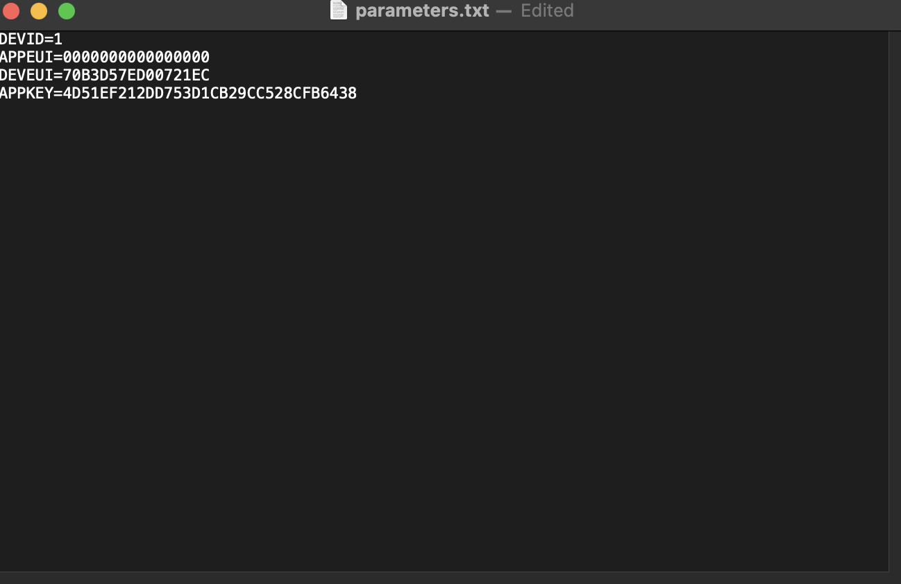
WiLoV2/WiLoV2 Documentation/Source/TTN_Add_WiLo_And_Application_Steps/Screenshot 2025-07-23 at 10.33.04.png
