21941211/WiLo/WiLoV2/WiLoV2 Documentation/Source/Tuning_SDI-12_Voltage.odp

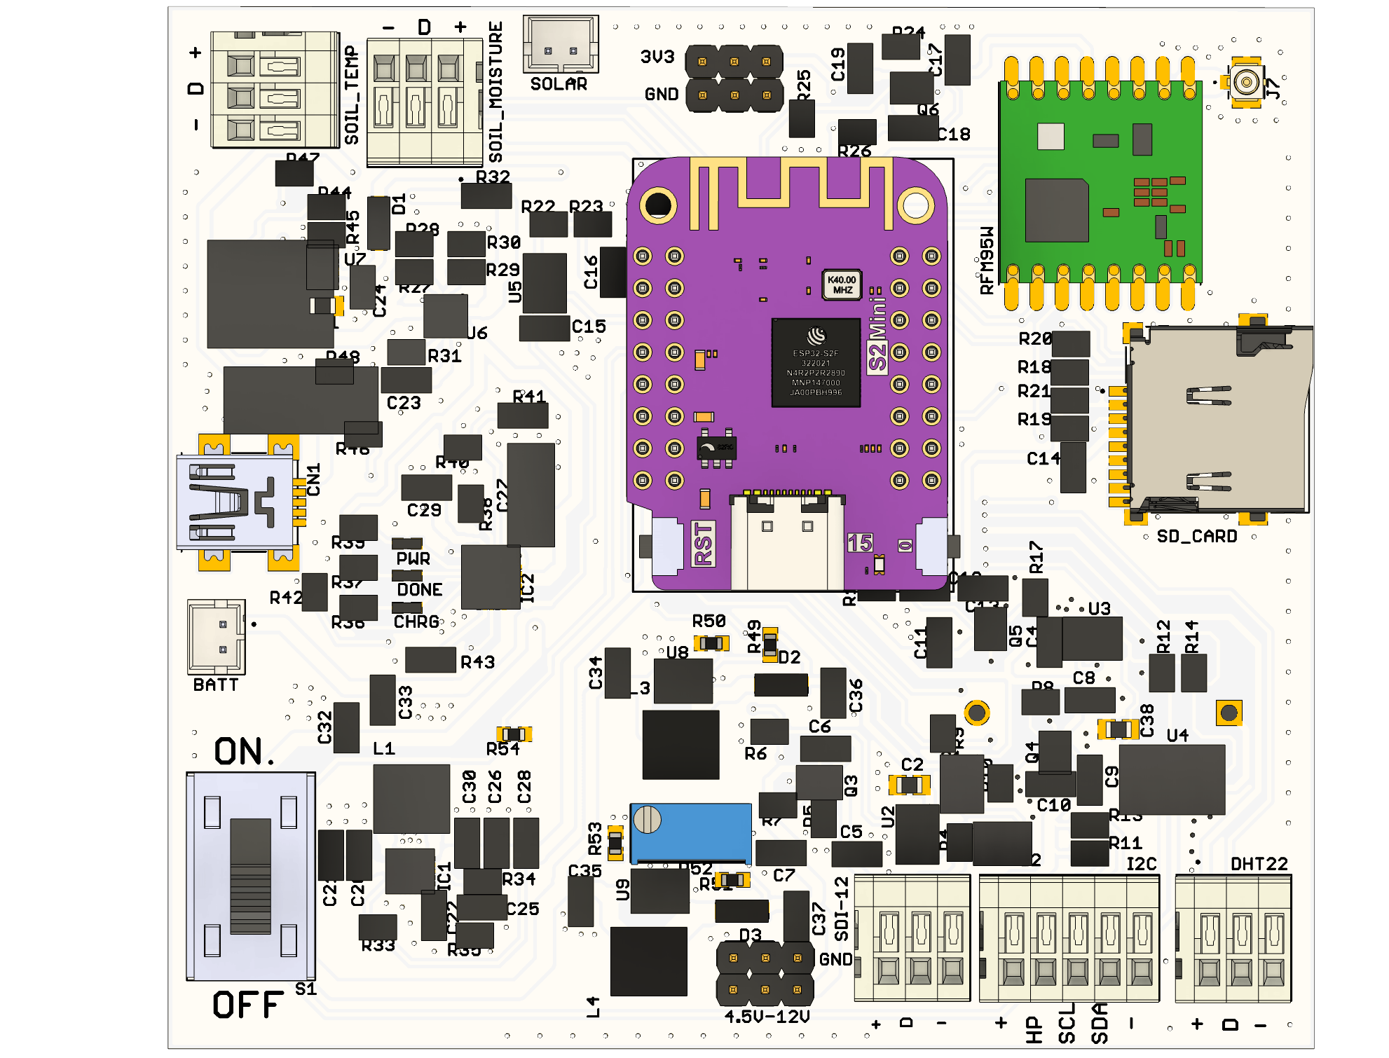
[picture p34: figure]
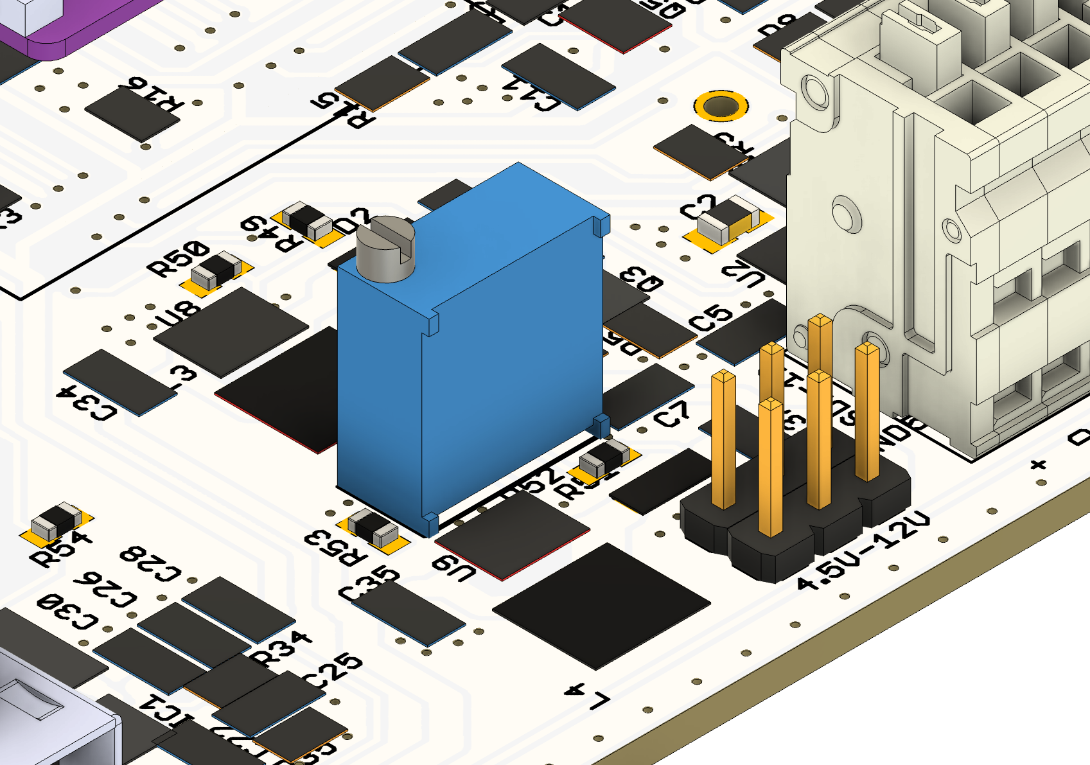
[picture p35: figure]

BLACK PROBE (-)

RED PROBE (+)

+
