21941211/WiLo/WiLoV2/WiLoV2 Documentation/Source/WiLoV2_Tuning_Iso.png

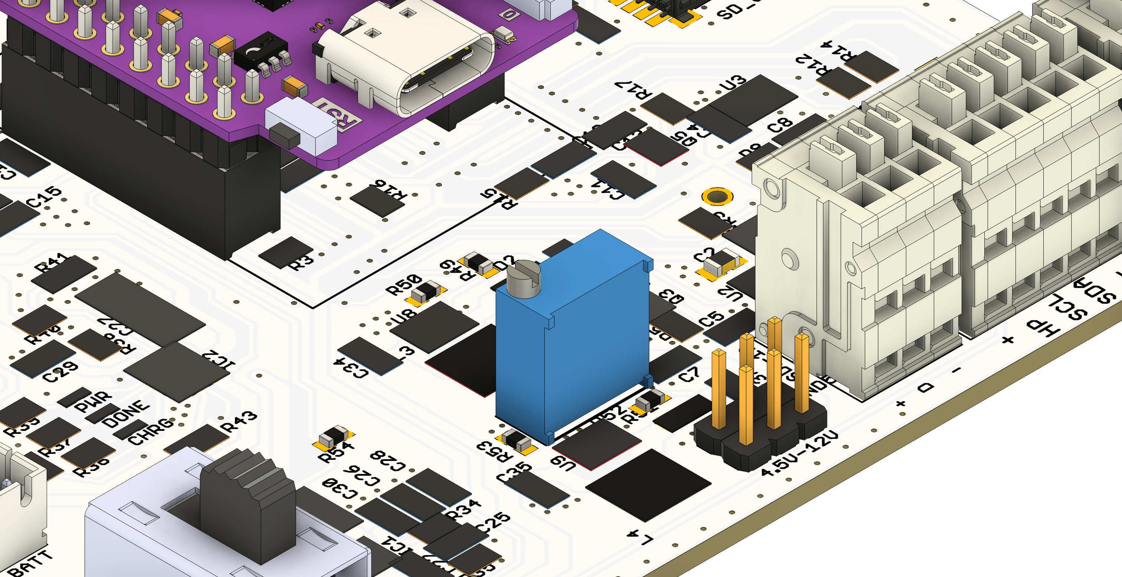
WiLoV2/WiLoV2 Documentation/Source/WiLoV2_Tuning_Iso.png
