21941211/WiLo/WiLoV2/CAD/Schematics/WiLoV2_Sheet1.pdf

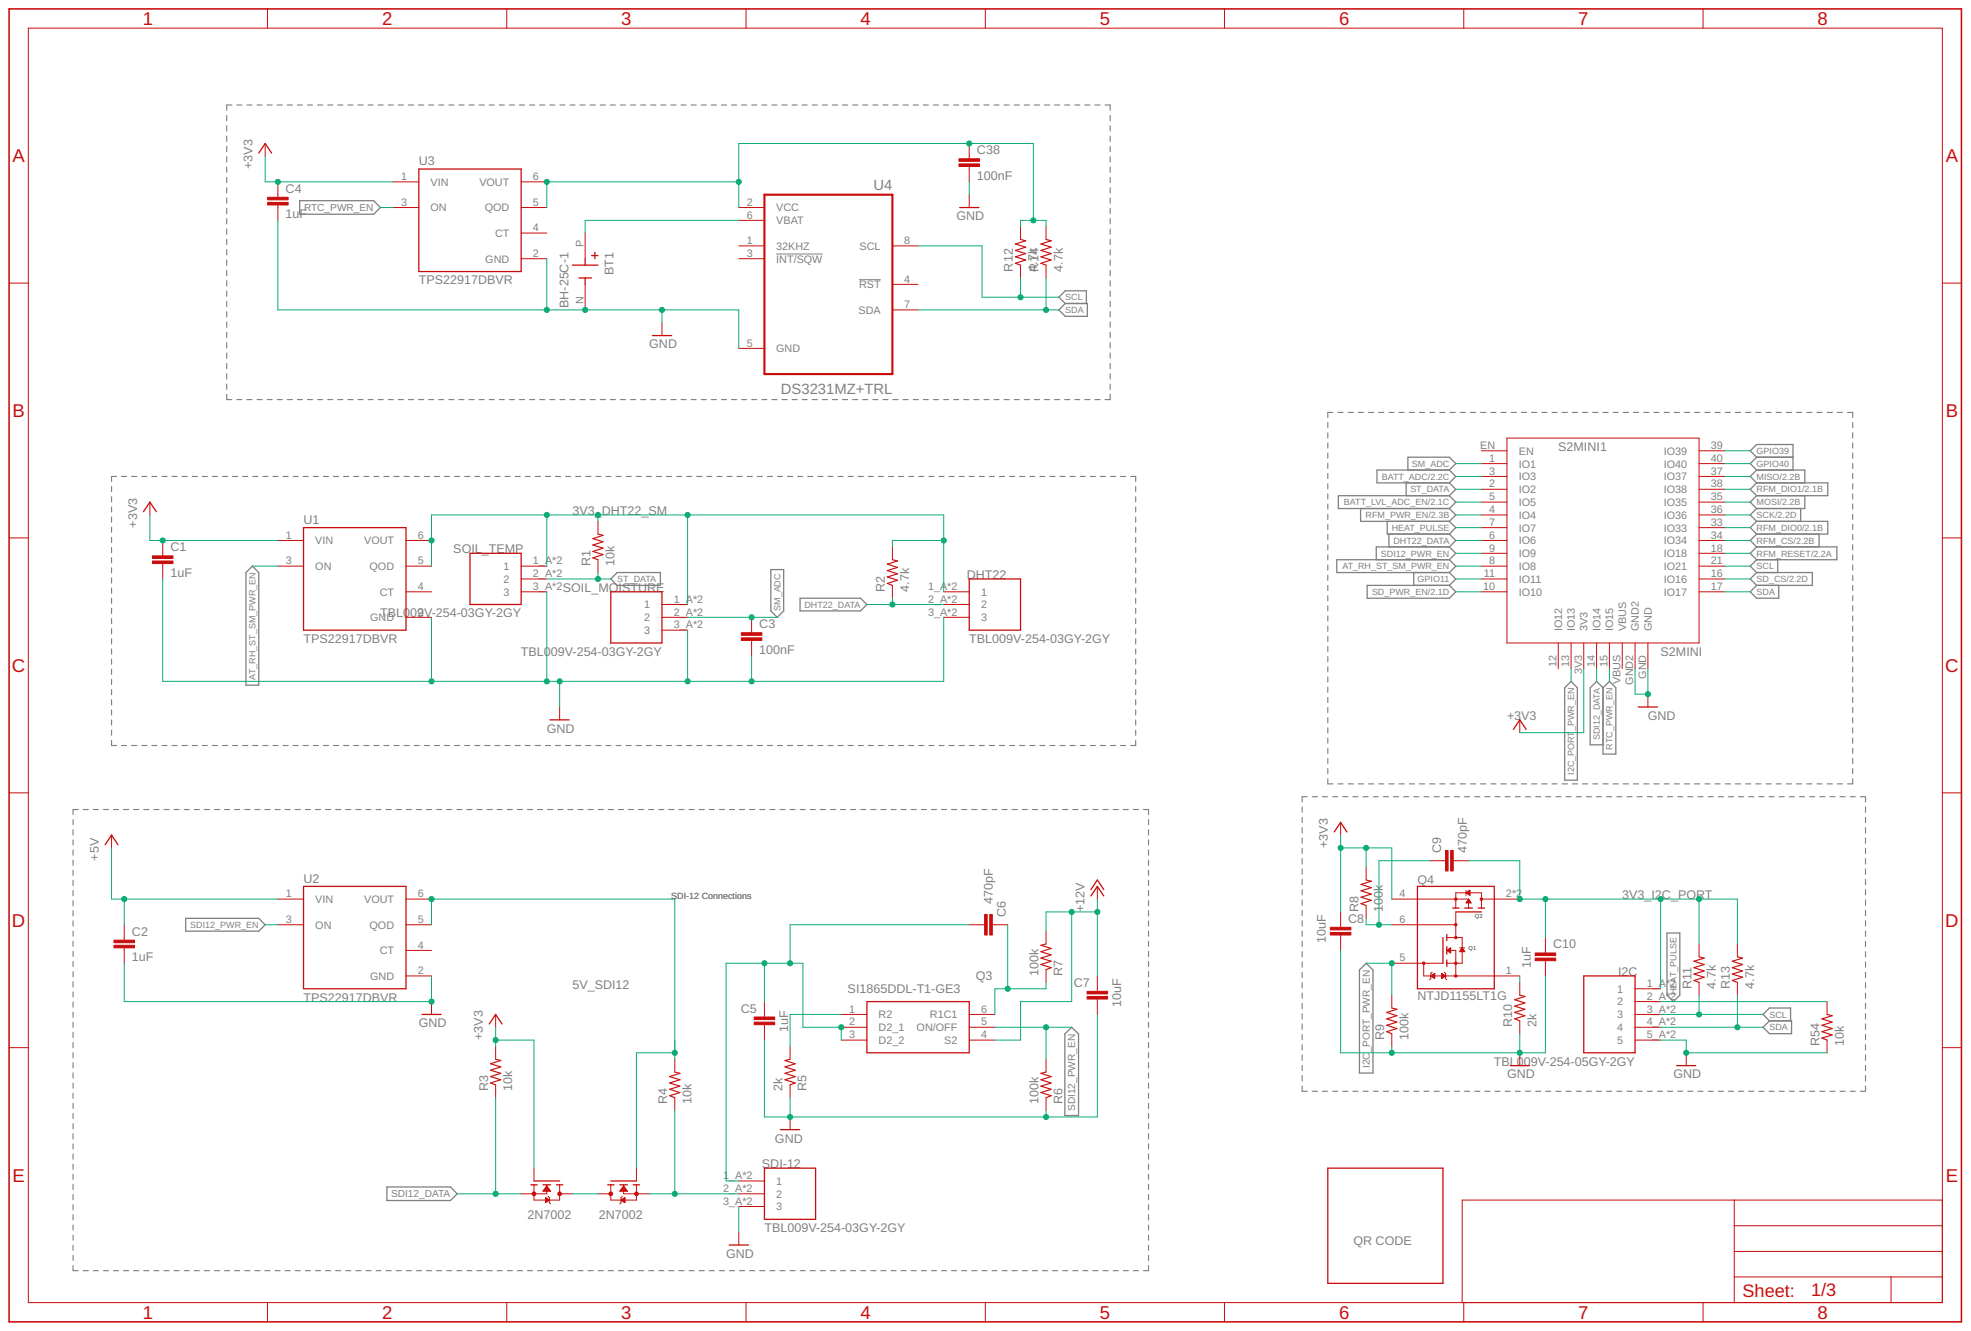
[picture p37: page 1]

SDI12_PWR_EN | 5 GND
