21941211/WiLo/WiLoV2/CAD/Schematics/WiLoV2_Sheet2.pdf

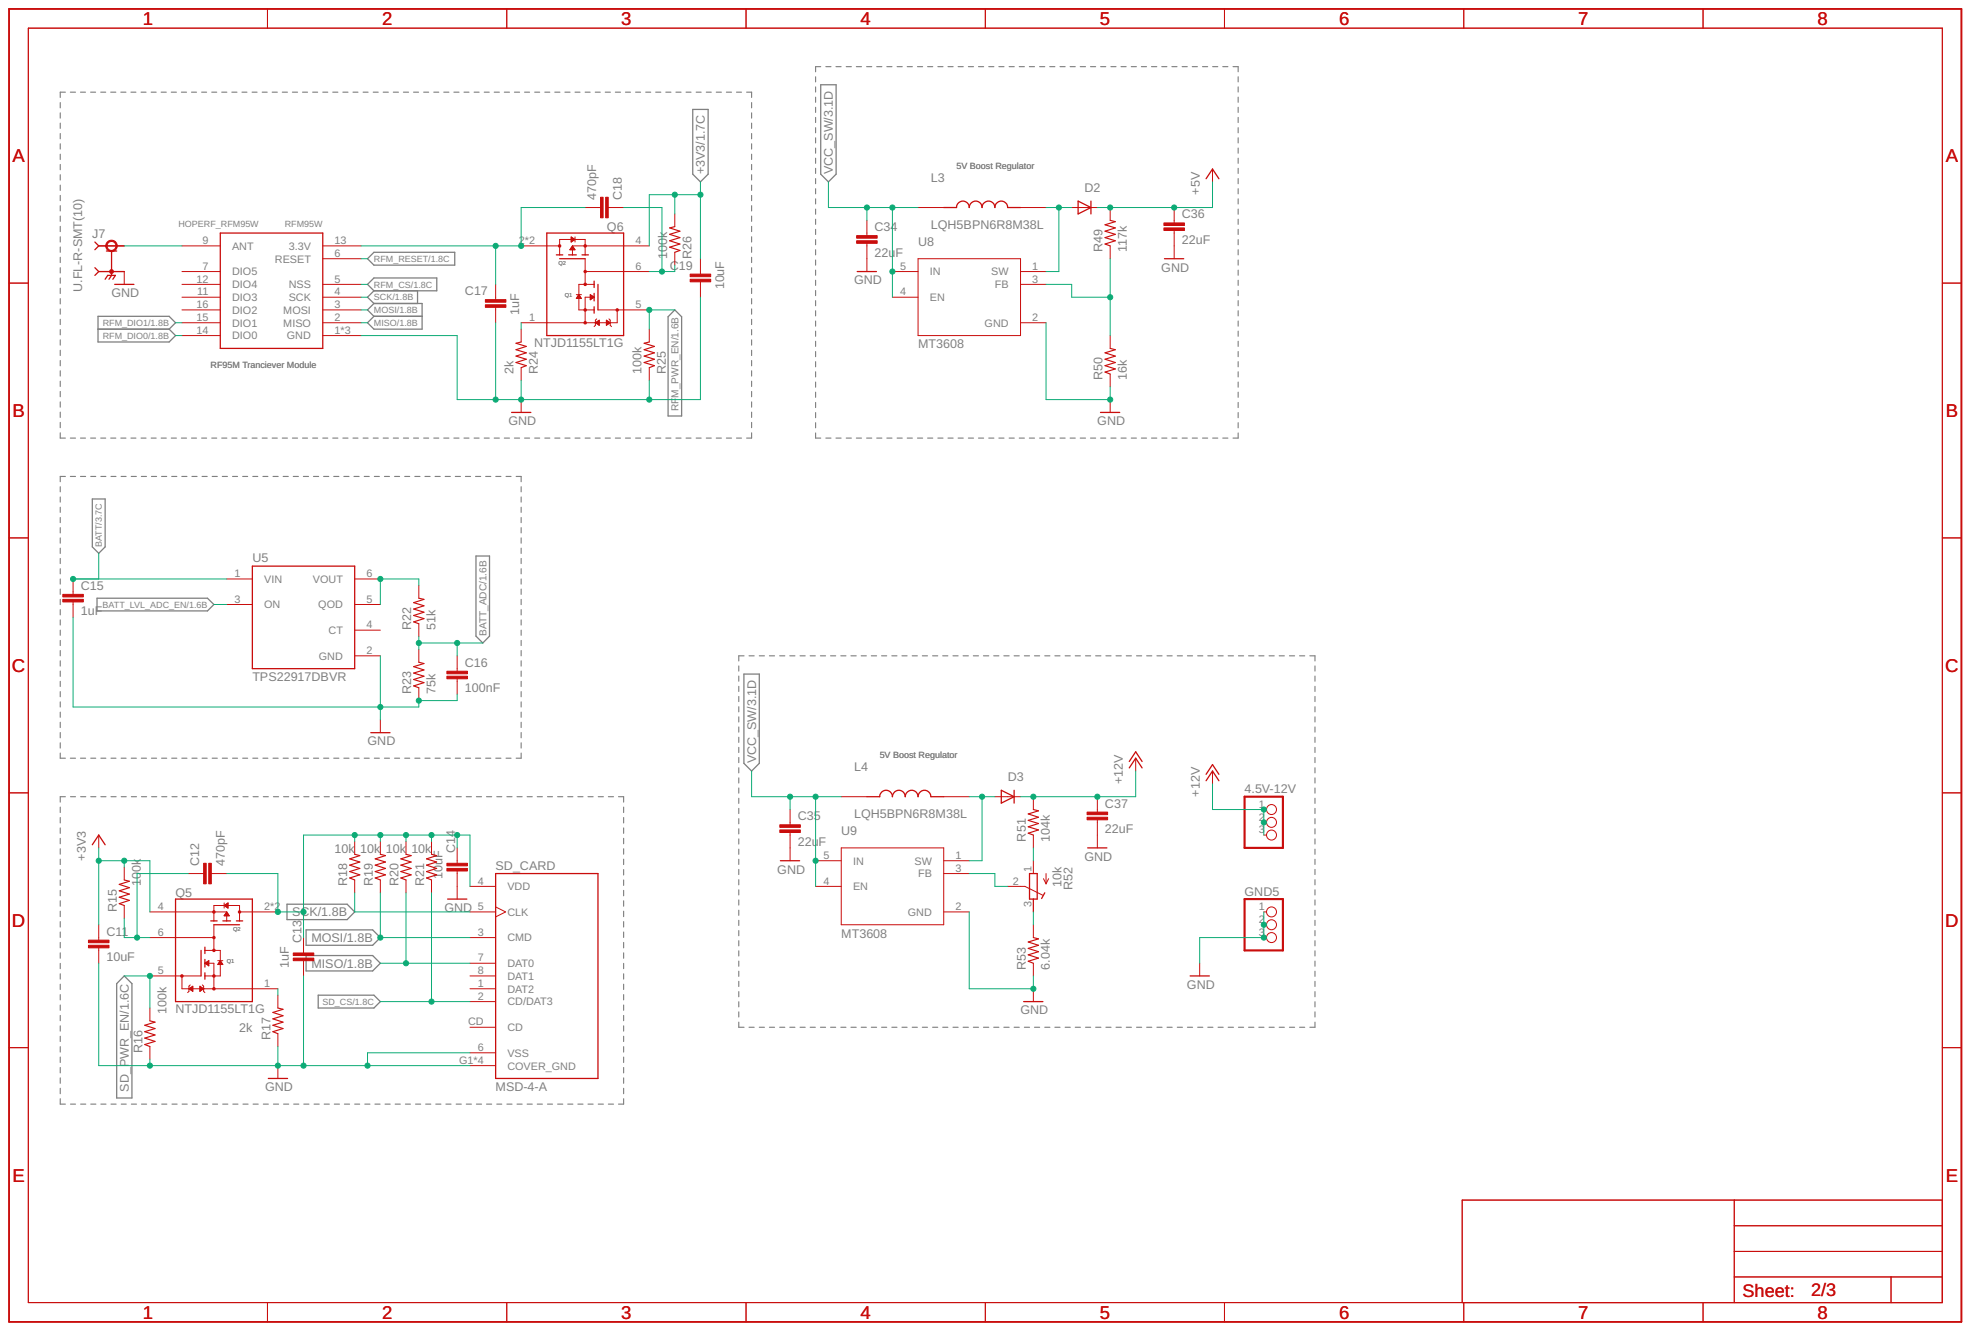
[picture p38: page 1]
