21941211/WiLo/WiLoV2/CAD/Schematics/WiLoV2_sheet3.pdf

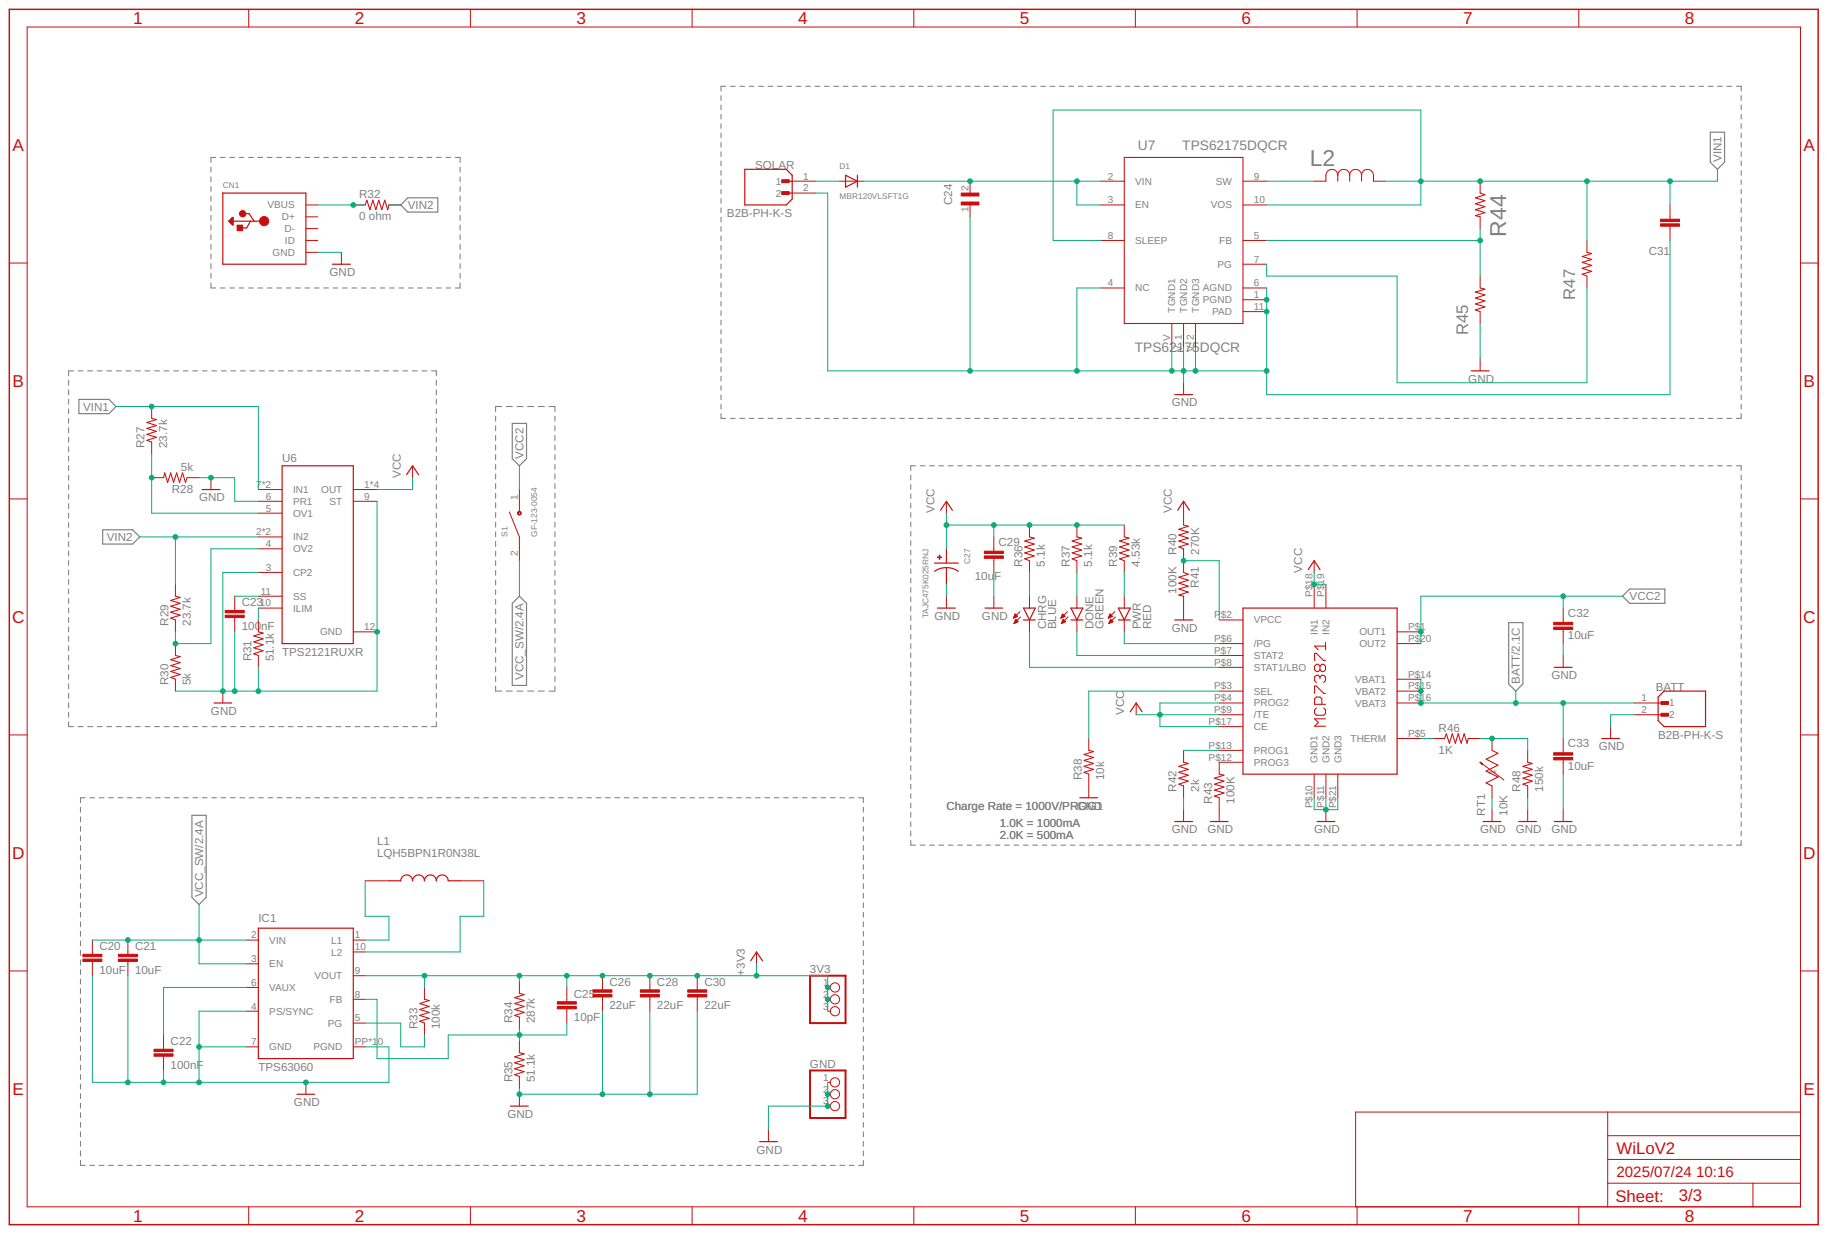
[picture p39: page 1]
