21941211/WiLo/SU_Forestry_SapFlow/dotmote_labs/sapflow-master/hardware/sapflow_gauge/kicad/sapflow_gauge/sapflow_gauge.kicad_pcb

## KiCad design SU_Forestry_SapFlow/dotmote_labs/sapflow-master/hardware/sapflow_gauge/kicad/sapflow_gauge/sapflow_gauge.kicad_pcb (2025-04-16)

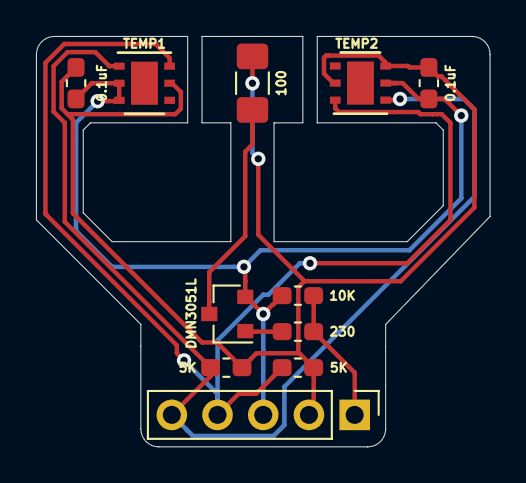
[picture p40: board sapflow_gauge.kicad_pcb from above]

Board: 2 copper layers, 25.2 x 22.8 mm, 11 parts (0 on the bottom side), 7 nets.

Parts:
0.1uF, 0.1uF#2: 0.1uF; C_0603_1608Metric_Pad1.05x0.95mm_HandSolder
5K, 5K#2: 5K; R_0603_1608Metric_Pad1.05x0.95mm_HandSolder
10K: 10K; R_0603_1608Metric_Pad1.05x0.95mm_HandSolder
100: 100; R_1206_3216Metric_Pad1.42x1.75mm_HandSolder
230: 230; R_0603_1608Metric_Pad1.05x0.95mm_HandSolder
 : Conn_01x05_Female; PinHeader_1x05_P2.54mm_Vertical
DMN3051L: DMN3051L; SOT-23
TEMP1, TEMP2: HDC2080; Texas_PWSON-N6

Connections:
+3V3: 0.1uF.1, 0.1uF#2.1, 5K.1, 5K#2.1, 100.2, .2, TEMP1.5, TEMP2.3, TEMP2.5
GND: 0.1uF.2, 0.1uF#2.2, 10K.1, .3, DMN3051L.2, TEMP1.2, TEMP1.3, TEMP2.2
unnamed: 10K.2, 230.1, .1
unnamed: 5K.2, .4, TEMP1.6, TEMP2.6
unnamed: 5K#2.2, .5, TEMP1.1, TEMP2.1
unnamed: 230.2, DMN3051L.1
unnamed: 100.1, DMN3051L.3
