21941211/WiLo/SU_Forestry_SapFlow/dotmote_labs/sapflow-master/hardware/microcontroller_shield/d1_mini/kicad/d1_mini_lite_sapflow_ti.kicad_pcb

## KiCad design SU_Forestry_SapFlow/dotmote_labs/sapflow-master/hardware/microcontroller_shield/d1_mini/kicad/d1_mini_lite_sapflow_ti.kicad_pcb (2025-04-16)

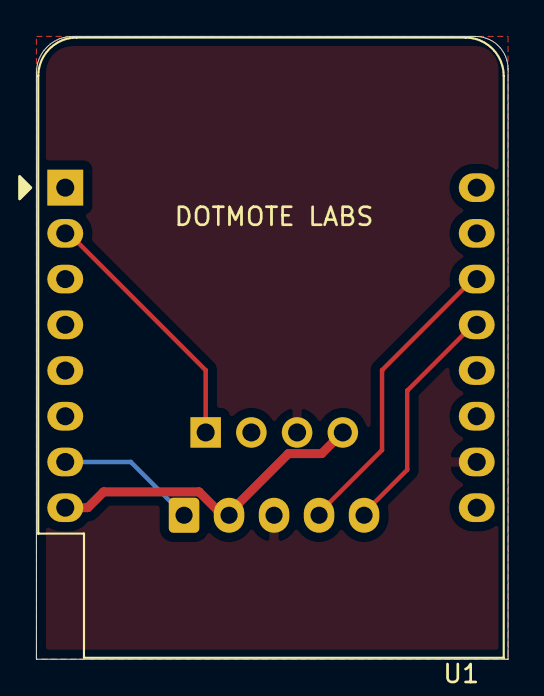
[picture p41: board d1_mini_lite_sapflow_ti.kicad_pcb from above]

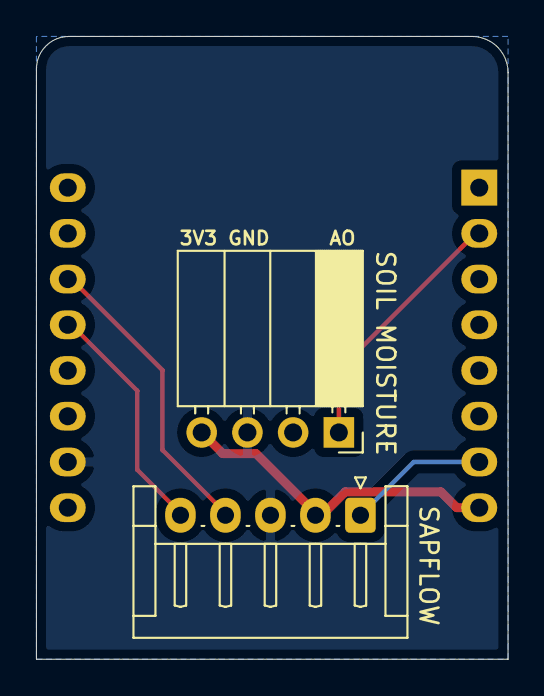
[picture p42: board d1_mini_lite_sapflow_ti.kicad_pcb from below]

Board: 2 copper layers, 26.2 x 34.6 mm, 3 parts (2 on the bottom side), 6 nets.

Parts:
SAPFLOW: sapflow_gauge_5_pin; JST_EH_S5B-EH_1x05_P2.50mm_Horizontal
SOIL MOISTURE: soil_moisture_4_pin; PinSocket_1x04_P2.54mm_Horizontal
U1: WeMos_D1_mini; WEMOS_D1_mini_light

Connections:
+3V3: SAPFLOW.2, SOIL MOISTURE.4, U1.8
GND: SAPFLOW.3, SOIL MOISTURE.3, U1.10
unnamed: SOIL MOISTURE.1, U1.2
unnamed: SAPFLOW.1, U1.7
unnamed: SAPFLOW.5, U1.13
unnamed: SAPFLOW.4, U1.14
