21941211/WiLo/SU_Forestry_SapFlow/dotmote_labs/sapflow-master/hardware/microcontroller_shield/d32_pro/kicad/d32_sapflow_rtc/d32_sapflow_rtc.kicad_pcb

## KiCad design SU_Forestry_SapFlow/dotmote_labs/sapflow-master/hardware/microcontroller_shield/d32_pro/kicad/d32_sapflow_rtc/d32_sapflow_rtc.kicad_pcb (2025-04-16)

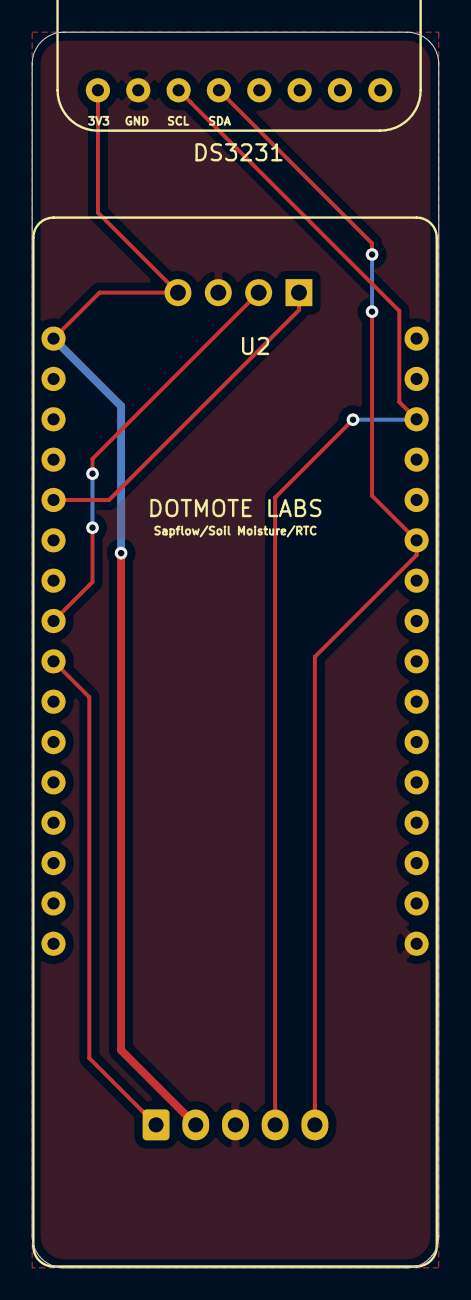
[picture p43: board d32_sapflow_rtc.kicad_pcb from above]

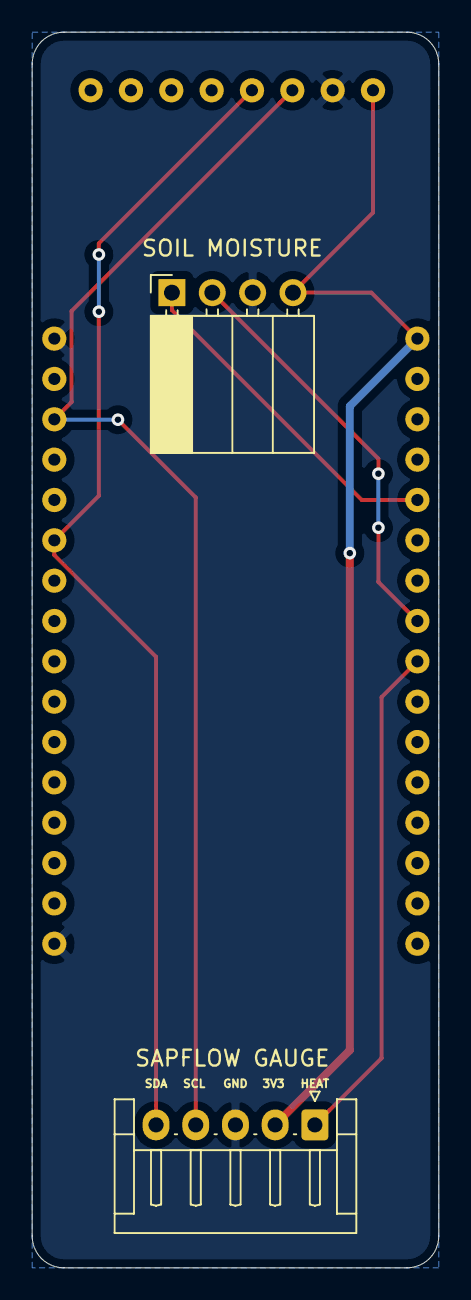
[picture p44: board d32_sapflow_rtc.kicad_pcb from below]

Board: 2 copper layers, 25.6 x 77.8 mm, 4 parts (2 on the bottom side), 7 nets.

Parts:
SAPFLOW GAUGE: sapflow_gauge_5_pin; JST_EH_S5B-EH_1x05_P2.50mm_Horizontal
SOIL MOISTURE: soil_moisture_4_pin; PinSocket_1x04_P2.54mm_Horizontal
U2: d32_pro
U4: adafruit_ds3231

Connections:
+3V3: SAPFLOW GAUGE.2, SOIL MOISTURE.4, U2.1, U4.1
GND: SAPFLOW GAUGE.3, SOIL MOISTURE.3, U2.17, U2.32, U4.2
unnamed: SOIL MOISTURE.1, U2.5
unnamed: SOIL MOISTURE.2, U2.8
unnamed: SAPFLOW GAUGE.1, U2.9
unnamed: SAPFLOW GAUGE.5, U2.27, U4.4
unnamed: SAPFLOW GAUGE.4, U2.30, U4.3
