21941211/WiLo/WiLoV2/CAD/Eagle/WiLoV2.brd

## EAGLE design WiLoV2/CAD/Eagle/WiLoV2.brd (2025-08-04)

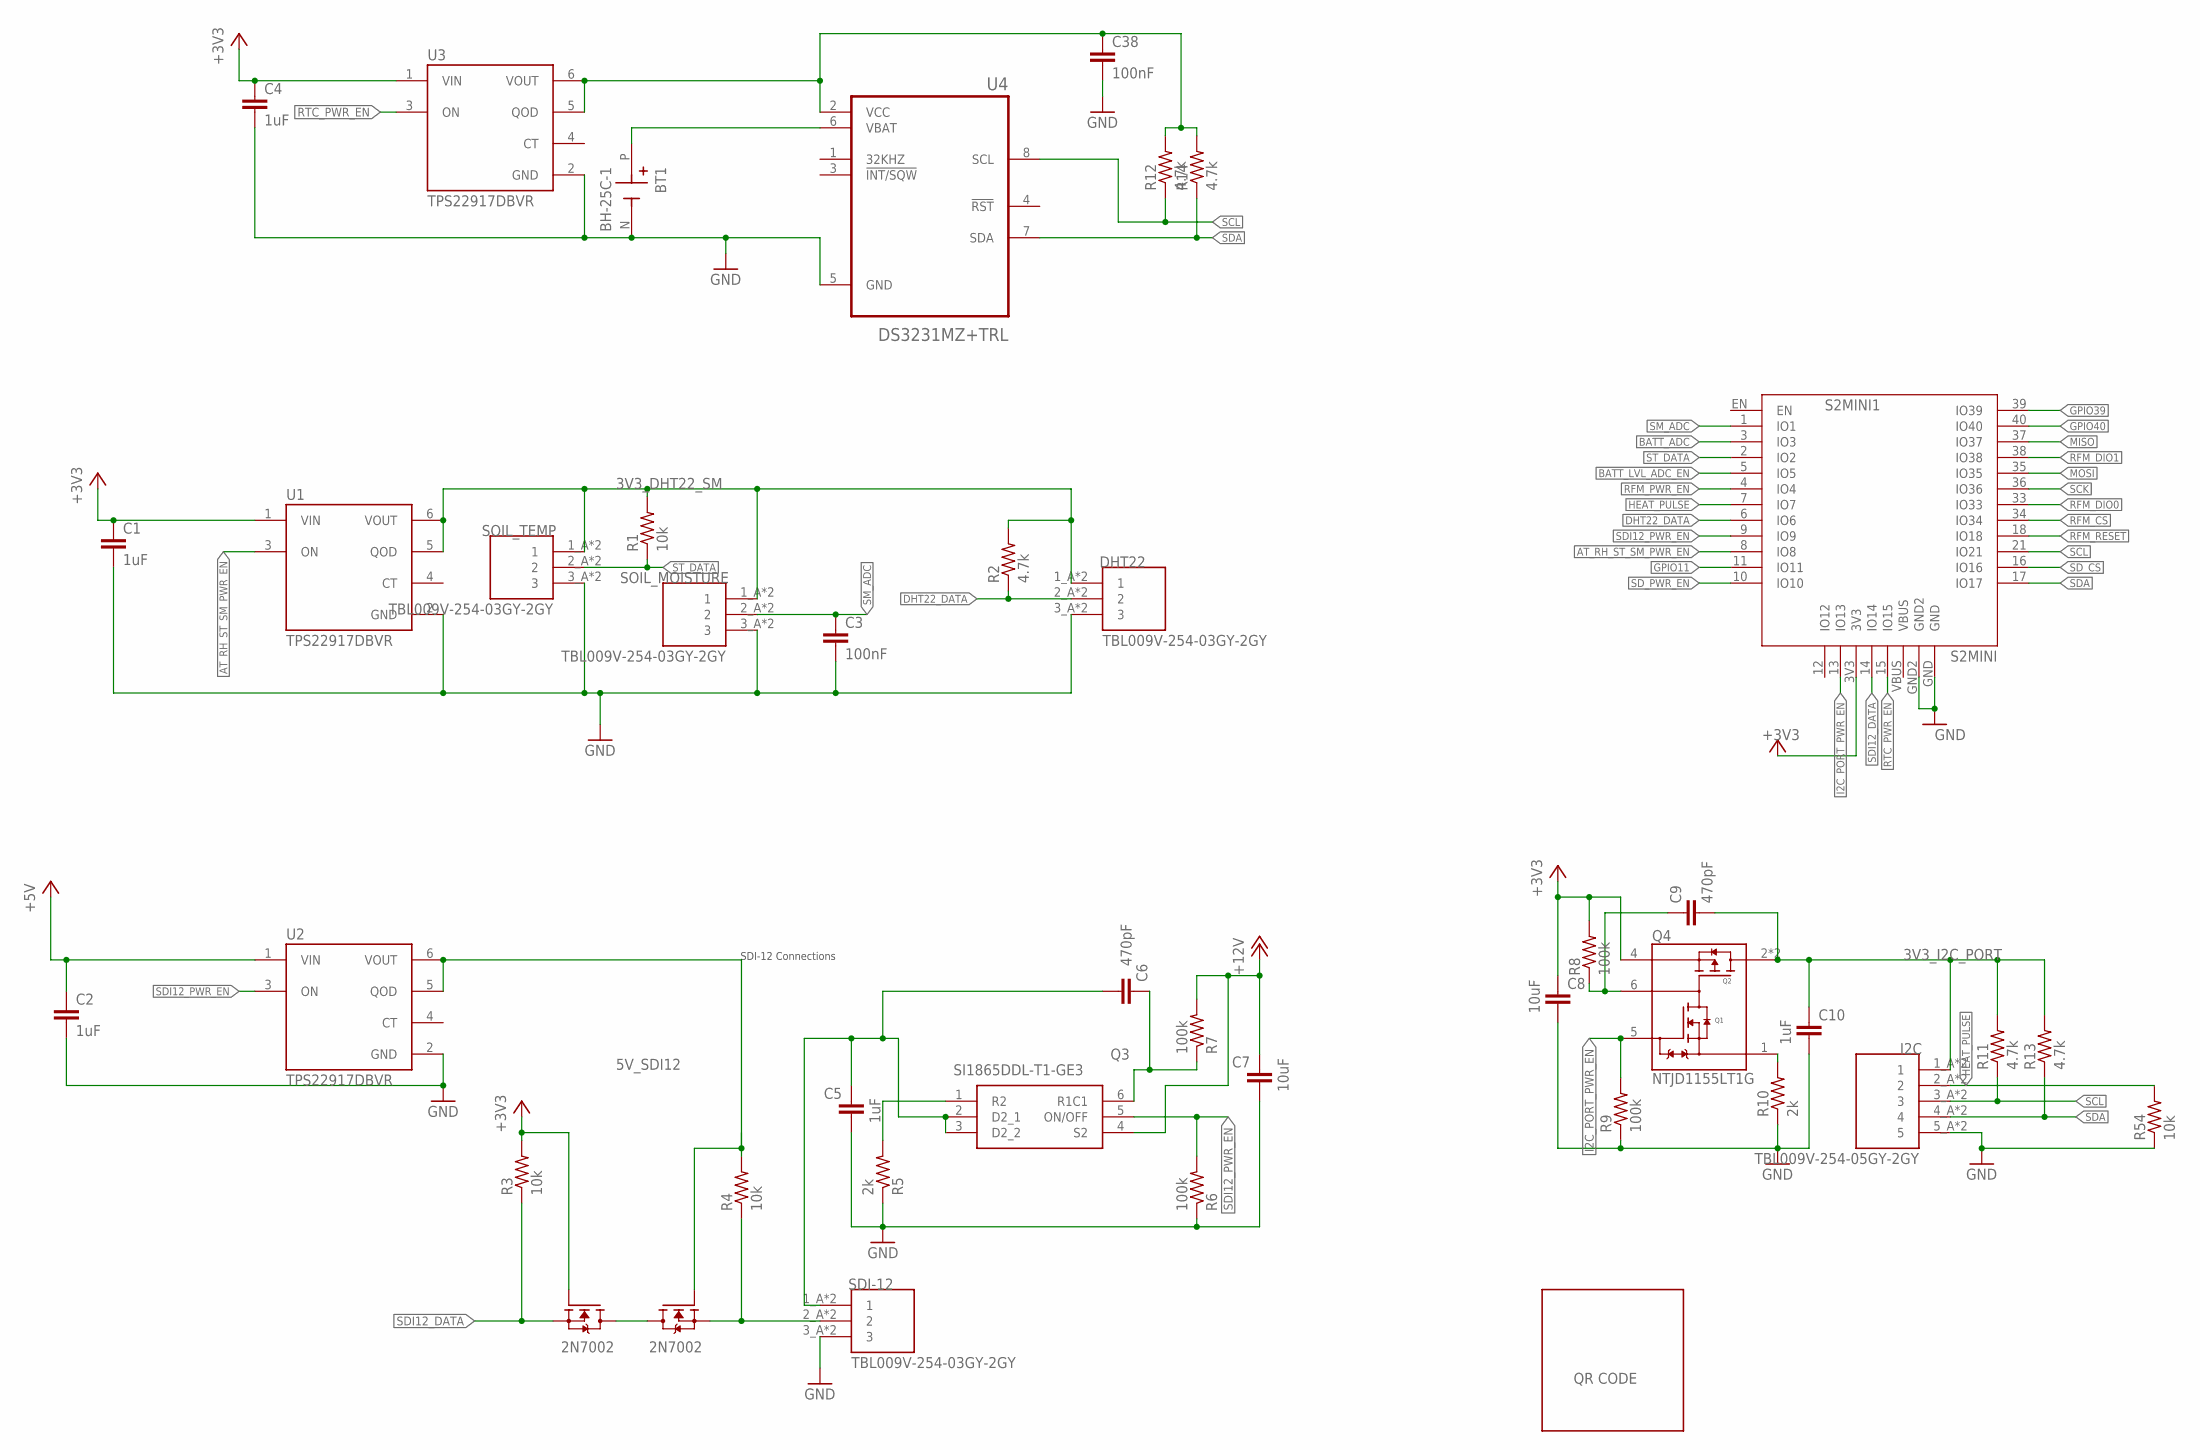
[picture p45: schematic WiLoV2.sch, sheet 1]

Parts:
BT1: BH-25C-1; BAT_BH-25C-1; MPN BH-25C-1
C1, C2, C4, C5, C10: 1uF; C0805; MPN CC0805KKX7R9BB105
C3, C38: 100nF; C0805; MPN KGM21NR71E104KT
C6, C9: 470pF; C0805; MPN CC0805JRNPOBBN471
C7, C8: 10uF; C0805; MPN GRM21BR61C106KE15K
DHT22: TBL009V-254-03GY-2GY; CUI_TBL009V-254-03GY-2GY; MPN TBL009V-254-03GY-2GY
I2C: TBL009V-254-05GY-2GY; CUI_TBL009V-254-05GY-2GY; MPN TBL009V-254-05GY-2GY
Q1, Q2: 2N7002; SOT95P240X111-3N; MPN 2N7002
Q3: SI1865DDL-T1-GE3; SOT65P210X110-6N; MPN SI1865DDL-T1-GE3
Q4: NTJD1155LT1G; TRANS_NTJD1155LT1G; MPN NTJD1155LT1G
QR_CODE: QR_CODE
R1, R3, R4, R54: 10k; R0603; MPN ERJ-U03F1002V
R2, R11, R12, R13, R14: 4.7k; R0603; MPN RK73G1JTTD4701C
R5, R10: 2k; R0603; MPN RC0603FR-072KL
R6, R7, R8, R9: 100k; R0603; MPN CRG0603F100K
S2MINI1: S2MINI
SDI-12: TBL009V-254-03GY-2GY; CUI_TBL009V-254-03GY-2GY; MPN TBL009V-254-03GY-2GY
SOIL_MOISTURE: TBL009V-254-03GY-2GY; CUI_TBL009V-254-03GY-2GY; MPN TBL009V-254-03GY-2GY
SOIL_TEMP: TBL009V-254-03GY-2GY; CUI_TBL009V-254-03GY-2GY; MPN TBL009V-254-03GY-2GY
U1, U2, U3: TPS22917DBVR; SOT95P280X145-6N; MPN TPS22917DBVT
U4: DS3231MZ+TRL; SOIC127P600X175-8N; MPN DS3231MZ+TRL

Connections:
3V3_DHT22_SM: DHT22.1_A (1), DHT22.1_B (1), R1.2, R2.2, SOIL_MOISTURE.1_A (1), SOIL_MOISTURE.1_B (1), SOIL_TEMP.1_A (1), SOIL_TEMP.1_B (1), U1.5 (QOD), U1.6 (VOUT)
3V3_I2C_PORT: C9.2, C10.1, I2C.1_A (1), I2C.1_B (1), Q4.2 (D2), Q4.3 (D2), R11.2, R13.2
5V_SDI12: Q2.1 (G), R4.2, U2.5 (QOD), U2.6 (VOUT)
+3V3: C1.1, C4.1, C8.1, Q1.1 (G), Q4.4 (S2), R3.2, R8.2, S2MINI1.3V3, U1.1 (VIN), U3.1 (VIN); also elsewhere on the board
+5V: C2.1, U2.1 (VIN); also elsewhere on the board
+12V: C7.1, Q3.4 (S2), R7.2; also elsewhere on the board
AT_RH_ST_SM_PWR_EN: S2MINI1.8 (IO8), U1.3 (ON)
BATT_ADC: S2MINI1.3 (IO3); also elsewhere on the board
BATT_LVL_ADC_EN: S2MINI1.5 (IO5); also elsewhere on the board
DHT22_DATA: DHT22.2_A (2), DHT22.2_B (2), R2.1, S2MINI1.6 (IO6)
GND: BT1.N, C1.2, C2.2, C3.2, C4.2, C5.2, C7.2, C8.2, C10.2, C38.2, DHT22.3_A (3), DHT22.3_B (3), I2C.5_A (5), I2C.5_B (5), R5.1, R6.1, R9.1, R10.1, R54.1, S2MINI1.GND, S2MINI1.GND2, SDI-12.3_A (3), SDI-12.3_B (3), SOIL_MOISTURE.3_A (3), SOIL_MOISTURE.3_B (3), SOIL_TEMP.3_A (3), SOIL_TEMP.3_B (3), U1.2 (GND), U2.2 (GND), U3.2 (GND), U4.5 (GND); also elsewhere on the board
GPIO11: S2MINI1.11 (IO11)
GPIO39: S2MINI1.39 (IO39)
GPIO40: S2MINI1.40 (IO40)
HEAT_PULSE: I2C.2_A (2), I2C.2_B (2), R54.2, S2MINI1.7 (IO7)
I2C_PORT_PWR_EN: Q4.5 (G1), R9.2, S2MINI1.13 (IO13)
MISO: S2MINI1.37 (IO37); also elsewhere on the board
MOSI: S2MINI1.35 (IO35); also elsewhere on the board
unnamed: Q1.3 (D), Q2.3 (D)
unnamed: C6.1, Q3.6 (R1C1), R7.1
unnamed: Q3.1 (R2), R5.2
unnamed: C9.1, Q4.6 (D1/G2), R8.1
unnamed: Q4.1 (S1), R10.2
unnamed: C5.1, C6.2, Q3.2 (D2_1), Q3.3 (D2_2), SDI-12.1_A (1), SDI-12.1_B (1)
unnamed: BT1.P, U4.6 (VBAT)
unnamed: C38.1, R12.2, R14.2, U3.5 (QOD), U3.6 (VOUT), U4.2 (VCC)
unnamed: Q2.2 (S), R4.1, SDI-12.2_A (2), SDI-12.2_B (2)
RFM_CS: S2MINI1.34 (IO34); also elsewhere on the board
RFM_DIO0: S2MINI1.33 (IO33); also elsewhere on the board
RFM_DIO1: S2MINI1.38 (IO38); also elsewhere on the board
RFM_PWR_EN: S2MINI1.4 (IO4); also elsewhere on the board
RFM_RESET: S2MINI1.18 (IO18); also elsewhere on the board
RTC_PWR_EN: S2MINI1.15 (IO15), U3.3 (ON)
SCK: S2MINI1.36 (IO36); also elsewhere on the board
SCL: I2C.3_A (3), I2C.3_B (3), R11.1, R12.1, S2MINI1.21 (IO21), U4.8 (SCL)
SDA: I2C.4_A (4), I2C.4_B (4), R13.1, R14.1, S2MINI1.17 (IO17), U4.7 (SDA)
SDI12_DATA: Q1.2 (S), R3.1, S2MINI1.14 (IO14)
SDI12_PWR_EN: Q3.5 (ON/OFF), R6.2, S2MINI1.9 (IO9), U2.3 (ON)
SD_CS: S2MINI1.16 (IO16); also elsewhere on the board
SD_PWR_EN: S2MINI1.10 (IO10); also elsewhere on the board
SM_ADC: C3.1, S2MINI1.1 (IO1), SOIL_MOISTURE.2_A (2), SOIL_MOISTURE.2_B (2)
ST_DATA: R1.1, S2MINI1.2 (IO2), SOIL_TEMP.2_A (2), SOIL_TEMP.2_B (2)

Notes on the sheet:
SDI-12 Connections

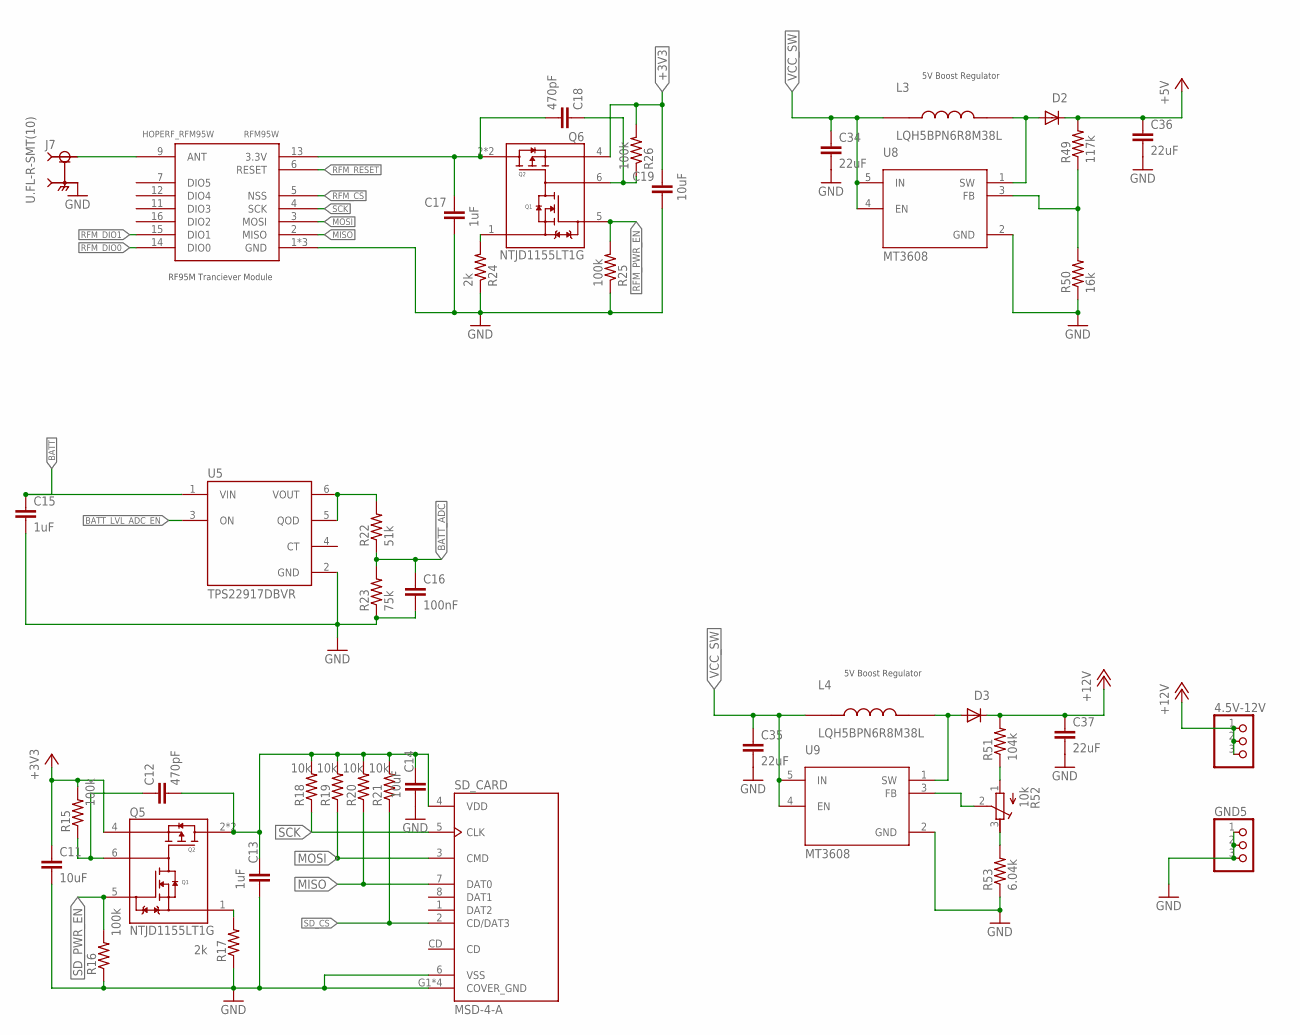
[picture p46: schematic WiLoV2.sch, sheet 2]

Parts:
4.5V-12V: PINHD-1X3; 1X03; MPN 61300311121
C11, C14, C19: 10uF; C0805; MPN GRM21BR61C106KE15K
C12, C18: 470pF; C0805; MPN CC0805JRNPOBBN471
C13, C15, C17: 1uF; C0805; MPN CC0805KKX7R9BB105
C16: 100nF; C0805; MPN KGM21NR71E104KT
C34, C35, C36, C37: 22uF; C0805; MPN CL21A226MOQNNNE
D2, D3: DIODE_SOD-123FL; SOD-123FL; MPN MBR120VLSFT1G
GND5: PINHD-1X3; 1X03; MPN 61300311121
J7: U.FL-R-SMT(10); HRS_U.FL-R-SMT(10); MPN U.FL-R-SMT-1(01)
L3, L4: LQH5BPN6R8M38L; IND_LQH5BPN6R8M38L; MPN LQH5BPN6R8M38L
Q5, Q6: NTJD1155LT1G; TRANS_NTJD1155LT1G; MPN NTJD1155LT1G
R15, R16, R25, R26: 100k; R0603; MPN CRG0603F100K
R17, R24: 2k; R0603; MPN RC0603FR-072KL
R18, R19, R20, R21: 10k; R0603; MPN ERJ-U03F1002V
R22: 51k; R0603; MPN RC0603FR-0751KL
R23: 75k; R0603; MPN AC0603FR-0775KL
R49: 117k; R0603; MPN RT0603DRE07117KL
R50: 16k; R0603; MPN RC0603FR-0716KL
R51: 104k; R0603; MPN RN73H1JTTD1043B50
R52: 10k; RTRIM3296W; MPN 3296W-1-103RLF
R53: 6.04k; R0603; MPN ERJ-3EKF6041V
RFM95W: HOPERF_RFM95W; MPN RFM95W-868S2
SD_CARD: MSD-4-A; CUI_MSD-4-A; MPN MSD-4-A
U5: TPS22917DBVR; SOT95P280X145-6N; MPN TPS22917DBVT
U8, U9: MT3608; SOT95P280X145-6N; MPN MT3608

Connections:
+3V3: C11.1, C19.1, Q5.4 (S2), Q6.4 (S2), R15.2, R26.2; also elsewhere on the board
+5V: C36.1, D2.C, R49.2; also elsewhere on the board
+12V: 4.5V-12V.1, 4.5V-12V.2, 4.5V-12V.3, C37.1, D3.C, R51.2; also elsewhere on the board
BATT: C15.1, U5.1 (VIN); also elsewhere on the board
BATT_ADC: C16.1, R22.1, R23.2; also elsewhere on the board
BATT_LVL_ADC_EN: U5.3 (ON); also elsewhere on the board
GND: C11.2, C13.2, C14.2, C15.2, C16.2, C17.2, C19.2, C34.2, C35.2, C36.2, C37.2, GND5.1, GND5.2, GND5.3, J7.2 (GND), J7.3 (GND), R16.1, R17.1, R23.1, R24.1, R25.1, R50.1, R53.1, RFM95W.1 (GND), RFM95W.8 (GND), RFM95W.10 (GND), SD_CARD.6 (VSS), SD_CARD.G1 (COVER_GND), SD_CARD.G2 (COVER_GND), SD_CARD.G3 (COVER_GND), SD_CARD.G4 (COVER_GND), U5.2 (GND), U8.2 (GND), U9.2 (GND); also elsewhere on the board
MISO: R20.1, RFM95W.2 (MISO), SD_CARD.7 (DAT0); also elsewhere on the board
MOSI: R19.1, RFM95W.3 (MOSI), SD_CARD.3 (CMD); also elsewhere on the board
unnamed: R22.2, U5.5 (QOD), U5.6 (VOUT)
unnamed: R51.1, R52.1 (A)
unnamed: D3.A, L4.2, U9.1 (SW)
unnamed: R52.2 (S), U9.3 (FB)
unnamed: R52.3 (E), R53.2
unnamed: C12.1, Q5.6 (D1/G2), R15.1
unnamed: Q5.1 (S1), R17.2
unnamed: D2.A, L3.2, U8.1 (SW)
unnamed: J7.1 (SIG), RFM95W.9 (ANT)
unnamed: R49.1, R50.2, U8.3 (FB)
unnamed: C12.2, C13.1, C14.1, Q5.2 (D2), Q5.3 (D2), R18.2, R19.2, R20.2, R21.2, SD_CARD.4 (VDD)
unnamed: C18.1, Q6.6 (D1/G2), R26.1
unnamed: Q6.1 (S1), R24.2
unnamed: C17.1, C18.2, Q6.2 (D2), Q6.3 (D2), RFM95W.13 (3.3V)
RFM_CS: RFM95W.5 (NSS); also elsewhere on the board
RFM_DIO0: RFM95W.14 (DIO0); also elsewhere on the board
RFM_DIO1: RFM95W.15 (DIO1); also elsewhere on the board
RFM_PWR_EN: Q6.5 (G1), R25.2; also elsewhere on the board
RFM_RESET: RFM95W.6 (RESET); also elsewhere on the board
SCK: R18.1, RFM95W.4 (SCK), SD_CARD.5 (CLK); also elsewhere on the board
SD_CS: R21.1, SD_CARD.2 (CD/DAT3); also elsewhere on the board
SD_PWR_EN: Q5.5 (G1), R16.2; also elsewhere on the board
VCC_SW: C34.1, C35.1, L3.1, L4.1, U8.4 (EN), U8.5 (IN), U9.4 (EN), U9.5 (IN); also elsewhere on the board

Notes on the sheet:
RF95M Tranciever Module
5V Boost Regulator

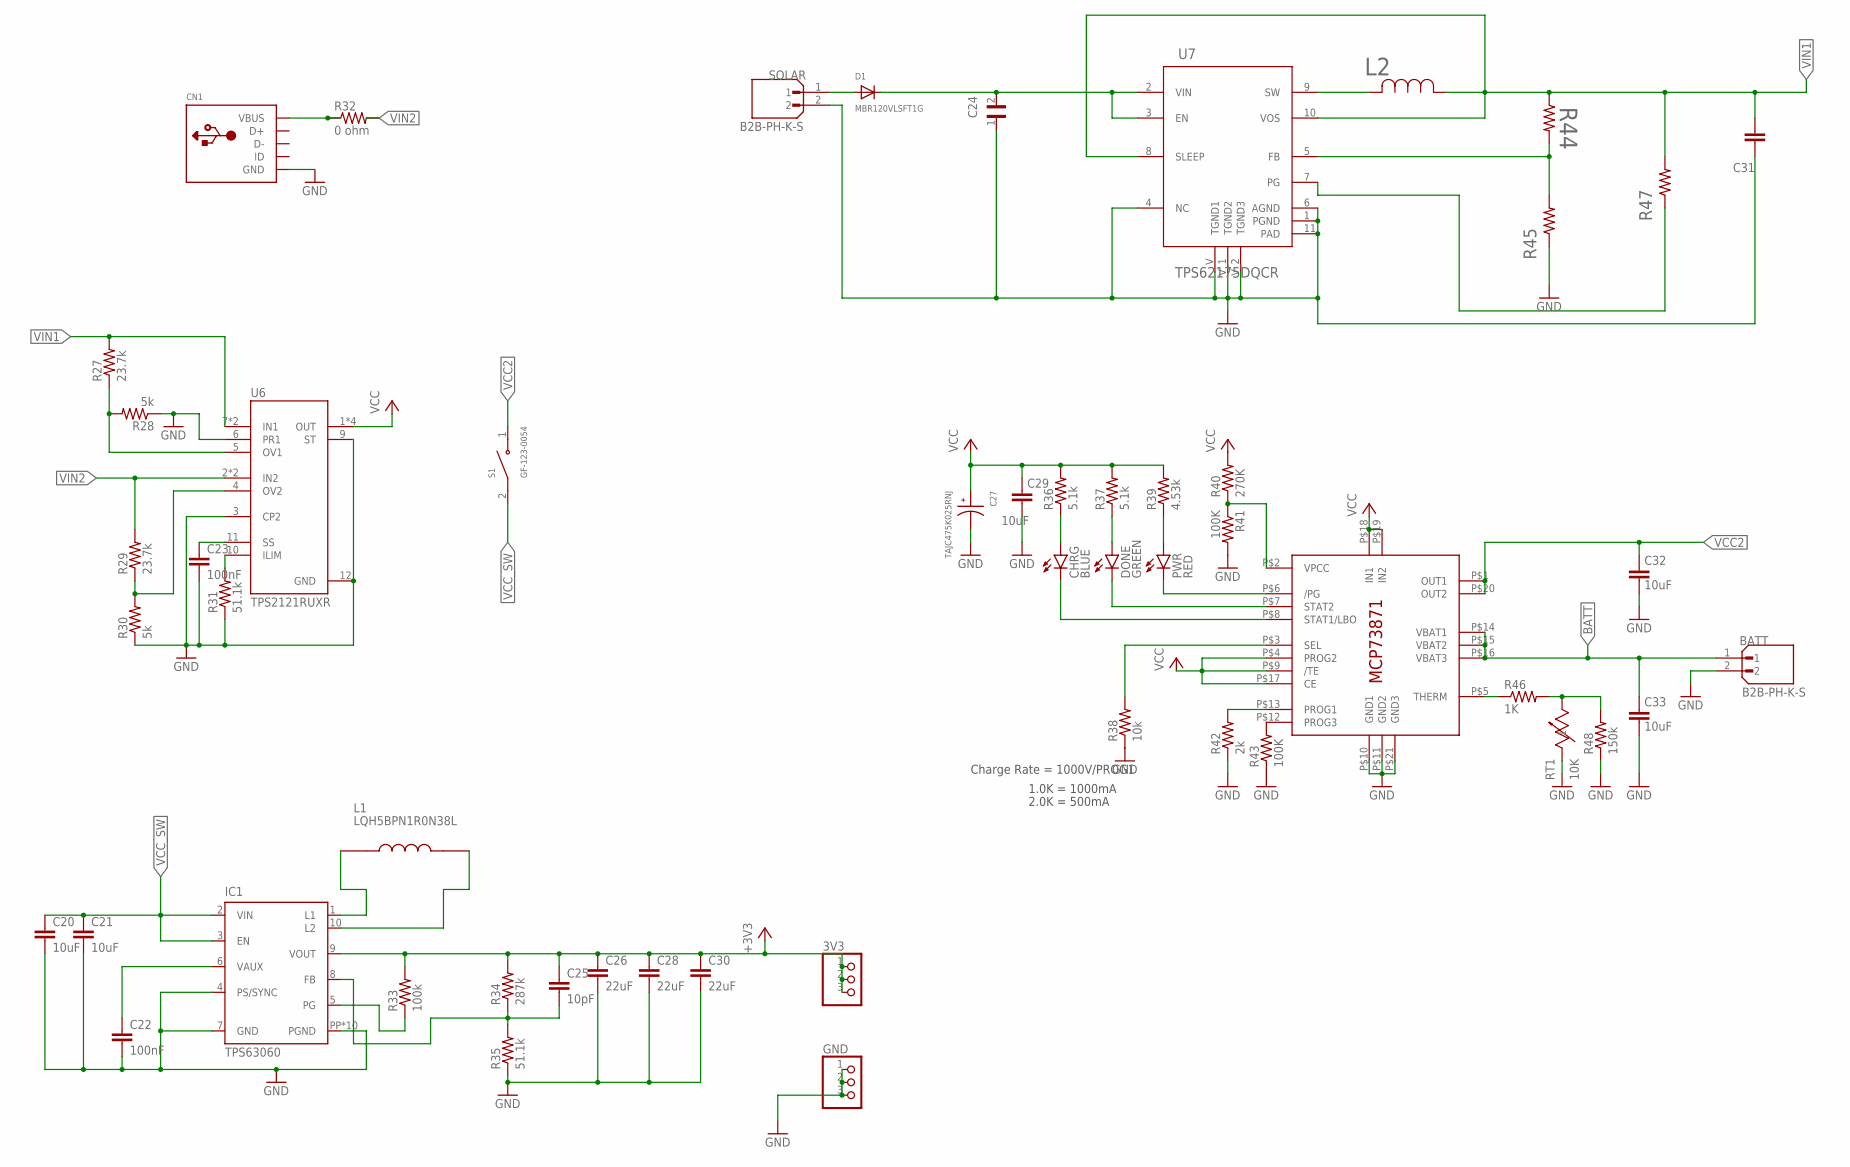
[picture p47: schematic WiLoV2.sch, sheet 3]

Parts:
3V3: PINHD-1X3; 1X03; MPN 61300311121
BATT: B2B-PH-K-S; JST_B2B-PH-K-S; MPN B2B-PH-K-S
C20, C21, C29, C32, C33: 10uF; C0805; MPN GRM21BR61C106KE15K
C22, C23: 100nF; C0805; MPN KGM21NR71E104KT
C24: 2.2uF; CAPC2012X145N; MPN CGA4J3X7R1H225K125AB
C25: 10pF; C0805; MPN C0805C100JDGACTU
C26, C28, C30, C31: 22uF; C0805; MPN CL21A226MOQNNNE
C27: TAJC475K025RNJ; CAPPM6032X280N; MPN TAJC475K025RNJ
CHRG: BLUE; SML0603; MPN XZCFBB53W-8VF
CN1: USBMINIB; USB-MINIB; MPN 690-005-299-043
D1: MBR120VLSFT1G; SOD-123FL; MPN MBR120VLSFT1G
DONE: GREEN; SML0603; MPN XZCDGK53W-8VF
GND: PINHD-1X3; 1X03; MPN 61300311121
IC1: TPS63060; DSC-S-PWSON-N10; MPN TPS63060DSCR
IC2: MCP73871; QFN20_4MM; MPN MCP73871T-2CCI/ML
L1: LQH5BPN1R0N38L; IND_LQH5BPN1R0N38L; MPN LQH5BPN1R0N38L
L2: 10uH; IND_IFSC_1515AH_VIS-M; MPN IFSC1515AHER100M01
PWR: RED; SML0603; MPN XZCM2CRK53WA-8VF
R27, R29: 23.7k; R0603; MPN ERJ-3EKF2372V
R28, R30: 5k; R0603; MPN RN73A1J5K0FTD
R31, R35: 51.1k; R0603; MPN RC0603FR-0751K1L
R32: 0 ohm; R0805; MPN ERJ-6GEY0R00V
R33, R47: 100k; R0603; MPN CRG0603F100K
R34: 287k; R0603; MPN ERJ-3EKF2873V
R36, R37: 5.1k; R0603; MPN ERA-3ARW512V
R38: 10k; R0603; MPN ERJ-U03F1002V
R39: 4.53k; R0603; MPN ERJ-3EKF4531V
R40: 270K; R0603; MPN ERJ-3EKF2703V
R41, R43: 100K; R0805; MPN RC0805FR-07100KL
R42: 2k; R0603; MPN RC0603FR-072KL
R44: 105k; R0603; MPN AC0603FR-07105KL
R45: 20k; R0603; MPN RC0603FR-0720KL
R46: 1K; R0603; MPN RMCF0603FT1K00
R48: 150k; R0603; MPN ERJ-3EKF1503V
RT1: 10K; G1_USS; MPN 103JG1F
S1: GF-123-0054; SW_GF-123-0054; MPN GF-123-0054
SOLAR: B2B-PH-K-S; JST_B2B-PH-K-S; MPN B2B-PH-K-S
U6: TPS2121RUXR; IC_TPS2121RUXR; MPN TPS2121RUXR
U7: TPS62175DQCR; DQC0010A; MPN TPS62175DQCR

Connections:
+3V3: 3V3.1, 3V3.2, 3V3.3, C25.1, C26.1, C28.1, C30.1, IC1.9 (VOUT), R33.2, R34.2; also elsewhere on the board
BATT: BATT.1, C33.1, IC2.P$14 (VBAT1), IC2.P$15 (VBAT2), IC2.P$16 (VBAT3); also elsewhere on the board
GND: BATT.2, C20.2, C21.2, C22.2, C23.2, C24.1, C26.2, C27.2, C28.2, C29.2, C30.2, C31.1, C32.2, C33.2, CN1.GND, GND.1, GND.2, GND.3, IC1.4 (PS/SYNC), IC1.7 (GND), IC1.PP (PGND), IC1.PP@1 (PGND), IC1.PP@2 (PGND), IC1.PP@3 (PGND), IC1.PP@4 (PGND), IC1.PP@5 (PGND), IC1.PP@7 (PGND), IC1.PP@8 (PGND), IC1.PP@9 (PGND), IC1.PP@10 (PGND), IC2.P$10 (GND1), IC2.P$11 (GND2), IC2.P$21 (GND3), R28.1, R30.1, R31.1, R35.1, R38.1, R41.2, R42.1, R43.1, R45.1, R48.1, RT1.1, SOLAR.2, U6.3 (CP2), U6.6 (PR1), U6.9 (ST), U6.12 (GND), U7.1 (PGND), U7.4 (NC), U7.6 (AGND), U7.11 (PAD), U7.V (TGND1), U7.V_1 (TGND2), U7.V_2 (TGND3); also elsewhere on the board
unnamed: IC1.1 (L1), L1.1
unnamed: IC1.10 (L2), L1.2
unnamed: C22.1, IC1.6 (VAUX)
unnamed: IC1.5 (PG), R33.1
unnamed: IC2.P$6 (/PG), PWR.C
unnamed: DONE.C, IC2.P$7 (STAT2)
unnamed: CHRG.C, IC2.P$8 (STAT1/LBO)
unnamed: CHRG.A, R36.1
unnamed: DONE.A, R37.1
unnamed: PWR.A, R39.1
unnamed: IC2.P$12 (PROG3), R43.2
unnamed: IC2.P$13 (PROG1), R42.2
unnamed: C24.2, D1.C, U7.2 (VIN), U7.3 (EN)
unnamed: IC2.P$5 (THERM), R46.1
unnamed: R46.2, R48.2, RT1.2
unnamed: CN1.VBUS, R32.1
unnamed: C25.2, IC1.8 (FB), R34.1, R35.2
unnamed: L2.2, U7.9 (SW)
unnamed: R44.2, R45.2, U7.5 (FB)
unnamed: R47.1, U7.7 (PG)
unnamed: R27.1, R28.2, U6.5 (OV1)
unnamed: R29.1, R30.2, U6.4 (OV2)
unnamed: R31.2, U6.10 (ILIM)
unnamed: C23.1, U6.11 (SS)
unnamed: IC2.P$3 (SEL), R38.2
unnamed: D1.A, SOLAR.1
VCC: C27.1, C29.1, IC2.P$4 (PROG2), IC2.P$9 (/TE), IC2.P$17 (CE), IC2.P$18 (IN1), IC2.P$19 (IN2), R36.2, R37.2, R39.2, R40.2, U6.1 (OUT), U6.1_1 (OUT), U6.8 (OUT), U6.8_1 (OUT)
VCC2: C32.1, IC2.P$1 (OUT1), IC2.P$20 (OUT2), S1.1
VCC_SW: C20.1, C21.1, IC1.2 (VIN), IC1.3 (EN), S1.2; also elsewhere on the board
VIN1: C31.2, L2.1, R27.2, R44.1, R47.2, U6.7 (IN1), U6.7_1 (IN1), U7.8 (SLEEP), U7.10 (VOS)
VIN2: R29.2, R32.2, U6.2 (IN2), U6.2_1 (IN2)
VPCC: IC2.P$2 (VPCC), R40.1, R41.1

Notes on the sheet:
Charge Rate = 1000V/PROG1
1.0K = 1000mA
2.0K = 500mA

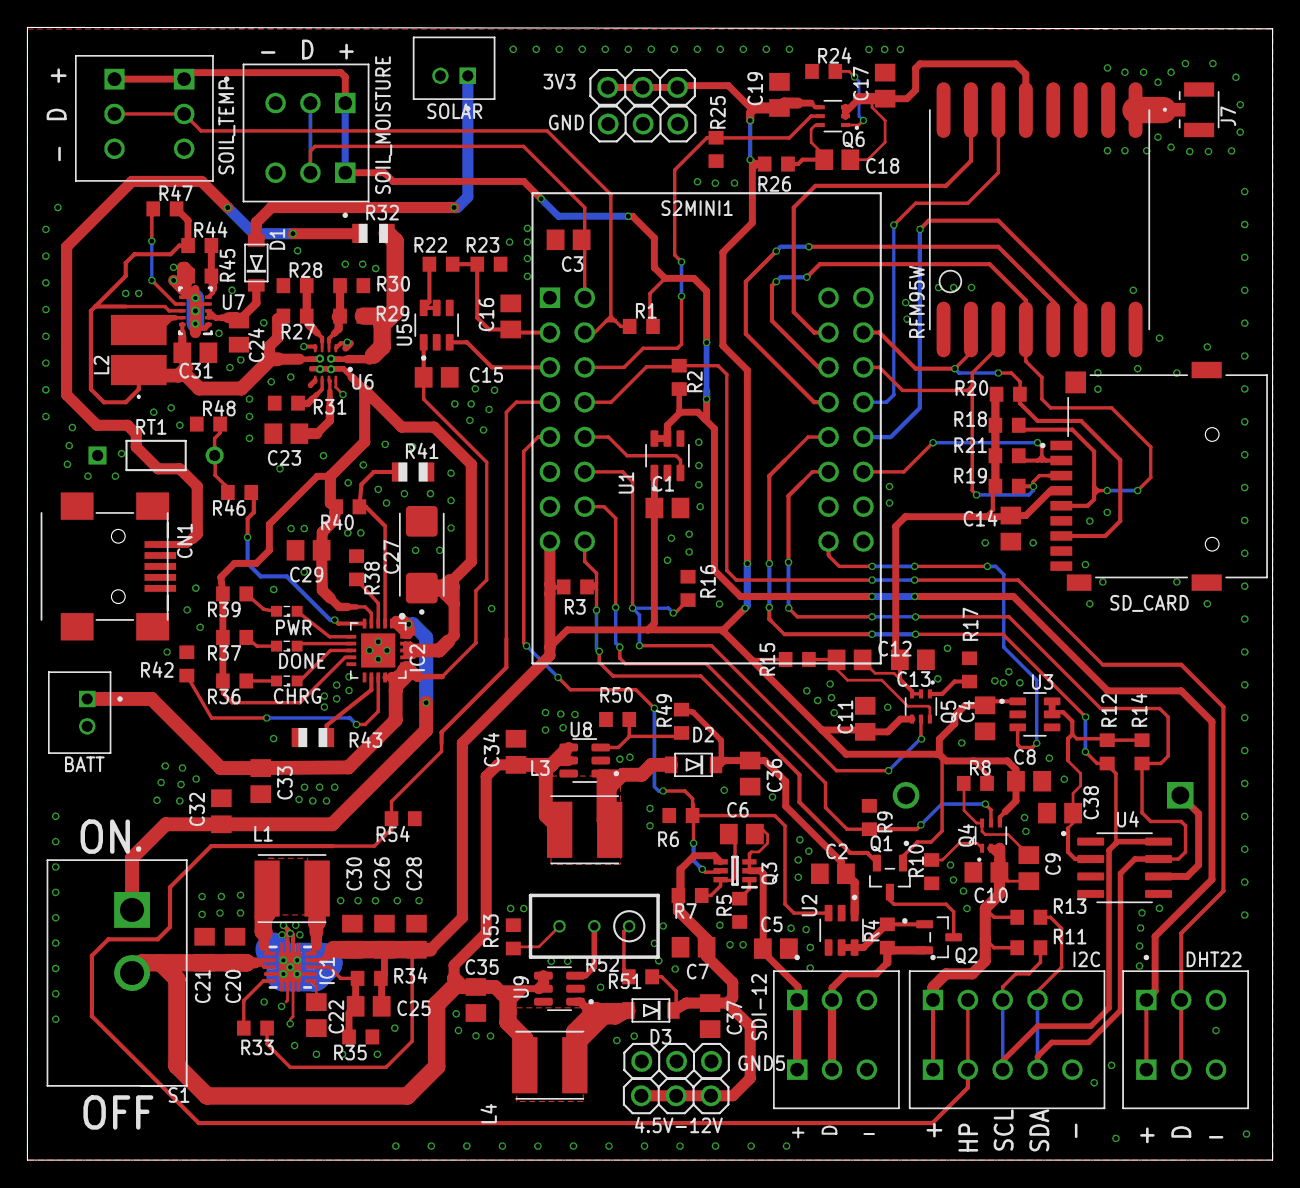
[picture p48: board WiLoV2.brd from above]

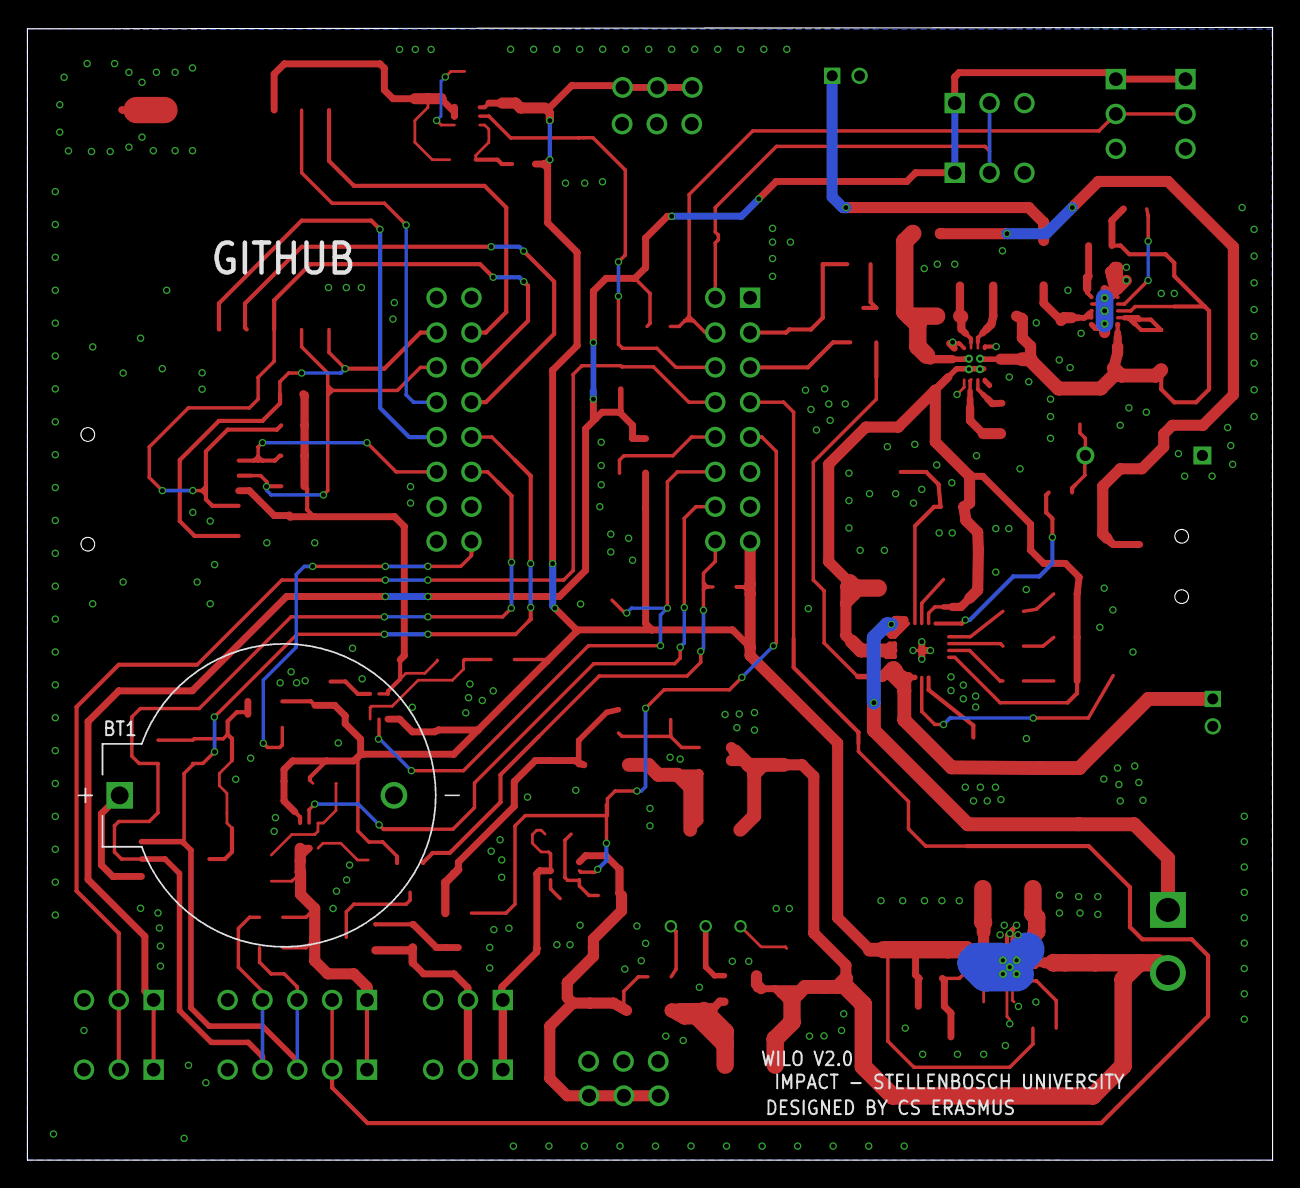
[picture p49: board WiLoV2.brd from below]

Board: 2 copper layers, 90.8 x 82.6 mm, 139 parts (2 on the bottom side), 86 nets.
