21941211/WiLo/DigiDendro - I2C Digitised Dendrometer/Eagle/DigiDendro.brd

## EAGLE design DigiDendro - I2C Digitised Dendrometer/Eagle/DigiDendro.brd (2025-07-03)

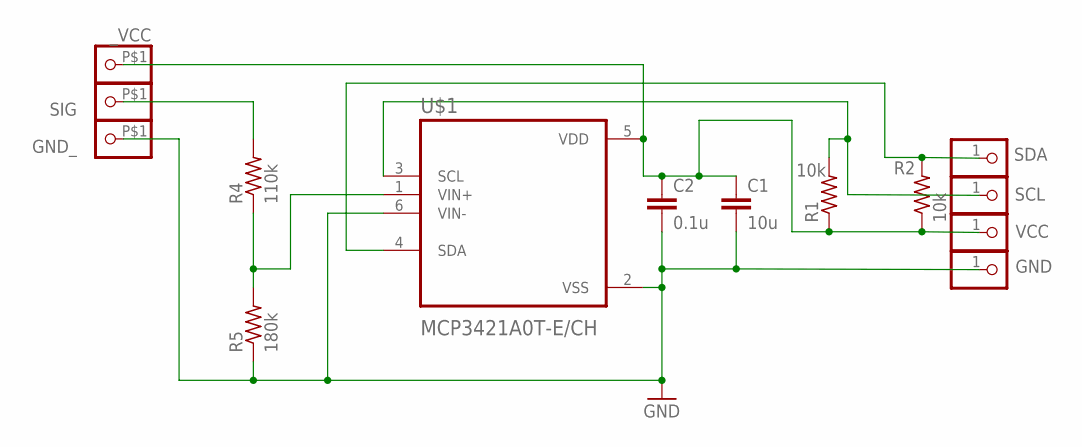
[picture p50: schematic DigiDendro.sch]

Parts:
C1: 10u; C0805
C2: 0.1u; C0805
GND: PINHD-1X1; 1X01
GND_: PINHD-1X1-BIGPOGO; 1X1-BIGPOGO
R1, R2: 10k; R0603
R4: 110k; R0603
R5: 180k; R0603
SCL: PINHD-1X1; 1X01
SDA: PINHD-1X1; 1X01
SIG: PINHD-1X1-BIGPOGO; 1X1-BIGPOGO
U$1: MCP3421A0T-E/CH; SOT95P280X145-6N
VCC: PINHD-1X1; 1X01
_VCC: PINHD-1X1-BIGPOGO; 1X1-BIGPOGO

Connections:
GND: C1.2, C2.2, GND.1, GND_.P$1, R5.1, U$1.2 (VSS), U$1.6 (VIN-)
unnamed: R4.2, SIG.P$1
unnamed: R4.1, R5.2, U$1.1 (VIN+)
SCL: R1.2, SCL.1, U$1.3 (SCL)
SDA: R2.2, SDA.1, U$1.4 (SDA)
VCC: C1.1, C2.1, R1.1, R2.1, U$1.5 (VDD), VCC.1, _VCC.P$1

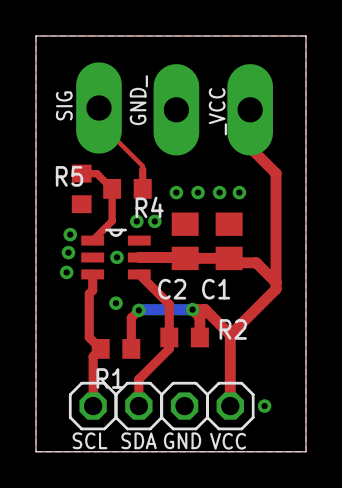
[picture p51: board DigiDendro.brd from above]

Board: 2 copper layers, 15.0 x 23.1 mm, 14 parts (0 on the bottom side), 6 nets.
