21941211/WiLo/WiLoV1/CAD/Eagle/WiLo V1.0.brd

## EAGLE design WiLoV1/CAD/Eagle/WiLo V1.0.brd (2025-04-16, an earlier design)

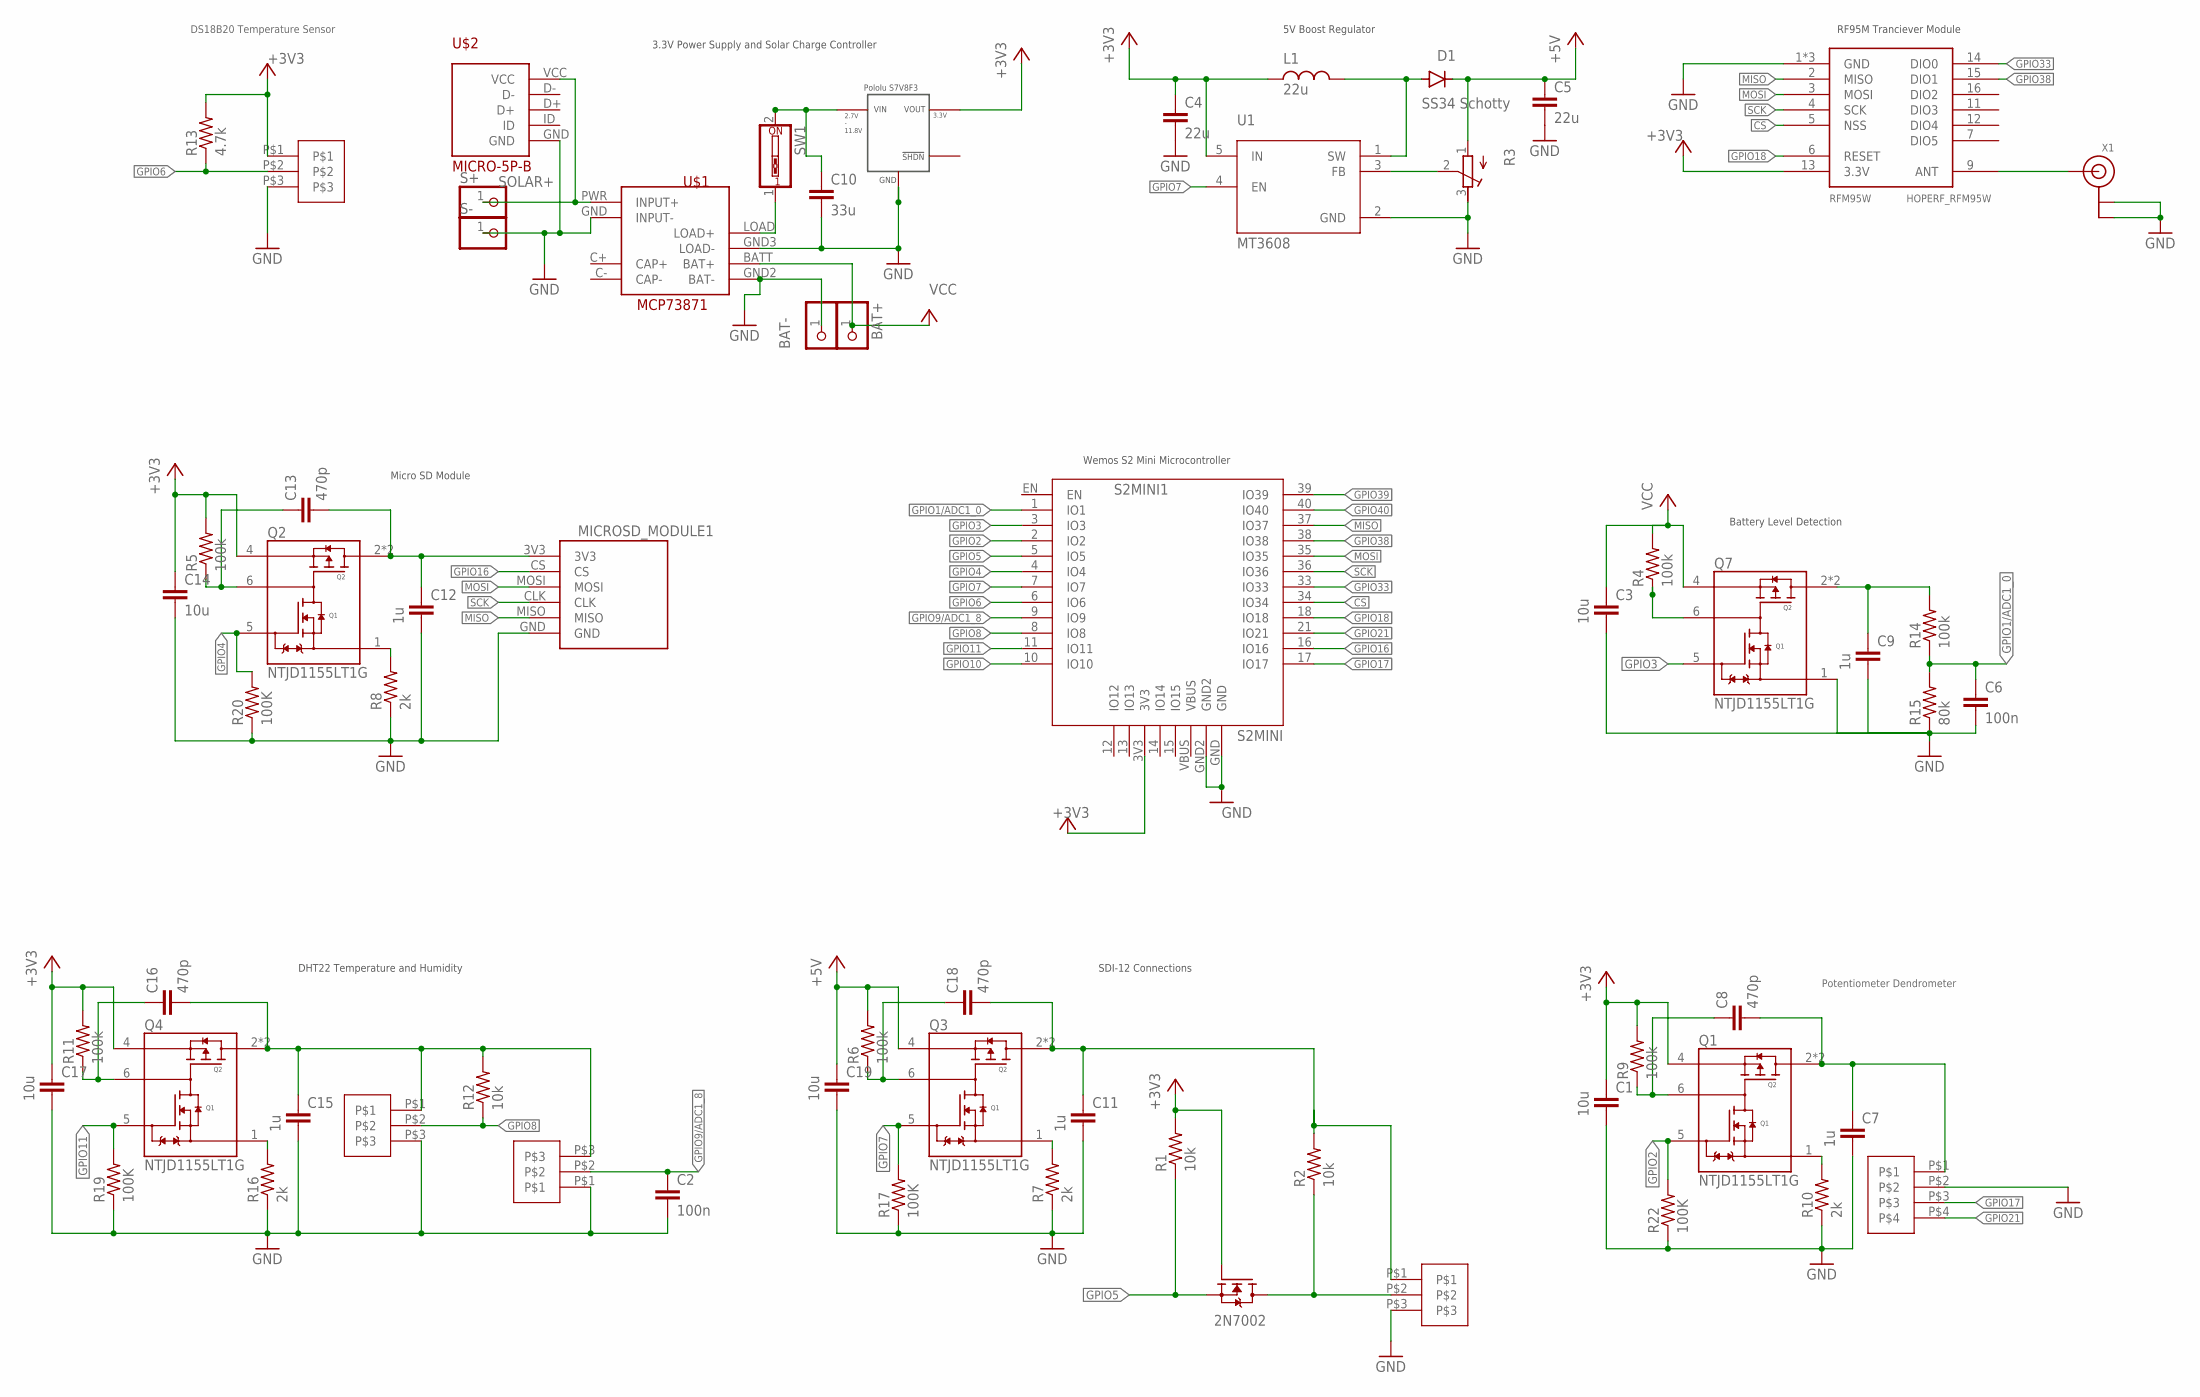
[picture p52: schematic WiLo V1.0.sch]

Parts:
BAT+: PINHD-1X1; 1X01
BAT-: PINHD-1X1; 1X01
C1, C3, C14, C17, C19: 10u; C0805
C2, C6: 100n; C0805
C4, C5: 22u; C0805
C7, C9, C11, C12, C15: 1u; C0805
C8, C13, C16, C18: 470p; C0805
C10: 33u; C025-024X044
D1: SS34 Schotty; DO214BA
L1: 22u; SLF7045
MICROSD_MODULE1: GENERIC_MICROSD_MODULE
Q1, Q2, Q3, Q4, Q7: NTJD1155LT1G; TRANS_NTJD1155LT1G
Q6: 2N7002; SOT95P240X111-3N
R1, R2, R12: 10k; R0603
R3: R-TRIMM3296W; RTRIM3296W
R4, R5, R6, R9, R11, R14: 100k; R0603
R7, R8, R10, R16: 2k; R0603
R13: 4.7k; R0603
R15: 80k; R0603
R17, R19, R20, R22: 100K; R0603
RFM95W: HOPERF_RFM95W
S2MINI1: S2MINI
S+: PINHD-1X1; 1X01
S-: PINHD-1X1; 1X01
SW1: SW_DIP-1; EDG-01
U1: MT3608; SOT95P280X145-6N
U$1: MCP73871
U$2: MICRO-5P-B
U$3: S7V8F3
U$4, U$5, U$6, U$7: 3PIN_2.54_SCREW
U$8: 4PIN_2.54_SCREW
X1: ANTENNA_U.FL; U.FL

Connections:
5V_SDI12: C11.1, C18.2, Q3.2 (D2), Q3.3 (D2), R2.2, U$7.P$1
+3V3: C1.1, C4.1, C14.1, C17.1, L1.+ (1), Q1.4 (S2), Q2.4 (S2), Q4.4 (S2), Q6.1 (G), R1.2, R5.2, R9.2, R11.2, R13.2, RFM95W.13 (3.3V), S2MINI1.3V3, U1.5 (IN), U$3.VOUT, U$4.P$1
+5V: C5.1, C19.1, D1.C, Q3.4 (S2), R3.1 (A), R6.2
CS: RFM95W.5 (NSS), S2MINI1.34 (IO34)
GND: BAT-.1, C1.2, C2.2, C3.2, C4.2, C5.2, C6.2, C7.2, C9.2, C10.2, C11.2, C12.2, C14.2, C15.2, C17.2, C19.2, MICROSD_MODULE1.GND, Q7.1 (S1), R3.3 (E), R7.1, R8.1, R10.1, R15.1, R16.1, R17.1, R19.1, R20.1, R22.1, RFM95W.1 (GND), RFM95W.8 (GND), RFM95W.10 (GND), S2MINI1.GND, S2MINI1.GND2, S-.1, U1.2 (GND), U$1.GND (INPUT-), U$1.GND2 (BAT-), U$1.GND3 (LOAD-), U$2.GND, U$3.GND, U$4.P$3, U$5.P$3, U$6.P$1, U$7.P$3, U$8.P$2, X1.1 (GND), X1.2 (GND)
GPIO1/ADC1_0: C6.1, R14.1, R15.2, S2MINI1.1 (IO1)
GPIO2: Q1.5 (G1), R22.2, S2MINI1.2 (IO2)
GPIO3: Q7.5 (G1), S2MINI1.3 (IO3)
GPIO4: Q2.5 (G1), R20.2, S2MINI1.4 (IO4)
GPIO5: Q6.2 (S), R1.1, S2MINI1.5 (IO5)
GPIO6: R13.1, S2MINI1.6 (IO6), U$4.P$2
GPIO7: Q3.5 (G1), R17.2, S2MINI1.7 (IO7), U1.4 (EN)
GPIO8: R12.1, S2MINI1.8 (IO8), U$5.P$2
GPIO9/ADC1_8: C2.1, S2MINI1.9 (IO9), U$6.P$2
GPIO10: S2MINI1.10 (IO10)
GPIO11: Q4.5 (G1), R19.2, S2MINI1.11 (IO11)
GPIO16: MICROSD_MODULE1.CS, S2MINI1.16 (IO16)
GPIO17: S2MINI1.17 (IO17), U$8.P$3
GPIO18: RFM95W.6 (RESET), S2MINI1.18 (IO18)
GPIO21: S2MINI1.21 (IO21), U$8.P$4
GPIO33: RFM95W.14 (DIO0), S2MINI1.33 (IO33)
GPIO38: RFM95W.15 (DIO1), S2MINI1.38 (IO38)
GPIO39: S2MINI1.39 (IO39)
GPIO40: S2MINI1.40 (IO40)
MISO: MICROSD_MODULE1.MISO, RFM95W.2 (MISO), S2MINI1.37 (IO37)
MOSI: MICROSD_MODULE1.MOSI, RFM95W.3 (MOSI), S2MINI1.35 (IO35)
unnamed: RFM95W.9 (ANT), X1.3 (SIGNAL)
unnamed: C18.1, Q3.6 (D1/G2), R6.1
unnamed: Q3.1 (S1), R7.2
unnamed: C8.1, Q1.6 (D1/G2), R9.1
unnamed: C7.1, C8.2, Q1.2 (D2), Q1.3 (D2), U$8.P$1
unnamed: Q1.1 (S1), R10.2
unnamed: D1.A, L1.- (2), U1.1 (SW)
unnamed: C10.1, SW1.2, U$3.VIN
unnamed: C9.1, Q7.2 (D2), Q7.3 (D2), R14.2
unnamed: R3.2 (S), U1.3 (FB)
unnamed: C13.1, Q2.6 (D1/G2), R5.1
unnamed: C12.1, C13.2, MICROSD_MODULE1.3V3, Q2.2 (D2), Q2.3 (D2)
unnamed: Q2.1 (S1), R8.2
unnamed: Q7.6 (D1/G2), R4.1
unnamed: C16.1, Q4.6 (D1/G2), R11.1
unnamed: C15.1, C16.2, Q4.2 (D2), Q4.3 (D2), R12.2, U$5.P$1, U$6.P$3
unnamed: Q4.1 (S1), R16.2
unnamed: Q6.3 (D), R2.1, U$7.P$2
unnamed: SW1.1, U$1.LOAD (LOAD+)
SCK: MICROSD_MODULE1.CLK, RFM95W.4 (SCK), S2MINI1.36 (IO36)
SOLAR+: S+.1, U$1.PWR (INPUT+), U$2.VCC
VCC: BAT+.1, C3.1, Q7.4 (S2), R4.2, U$1.BATT (BAT+)

Notes on the sheet:
3.3V Power Supply and Solar Charge Controller
RF95M Tranciever Module
Wemos S2 Mini Microcontroller
Battery Level Detection
Micro SD Module
DS18B20 Temperature Sensor
Potentiometer Dendrometer
DHT22 Temperature and Humidity
SDI-12 Connections
5V Boost Regulator
