21941211/WiLo/WiLoV1/CAD/Eagle/WiLo V1.0.brd

## EAGLE design WiLoV1/CAD/Eagle/WiLo V1.0.brd (continued)

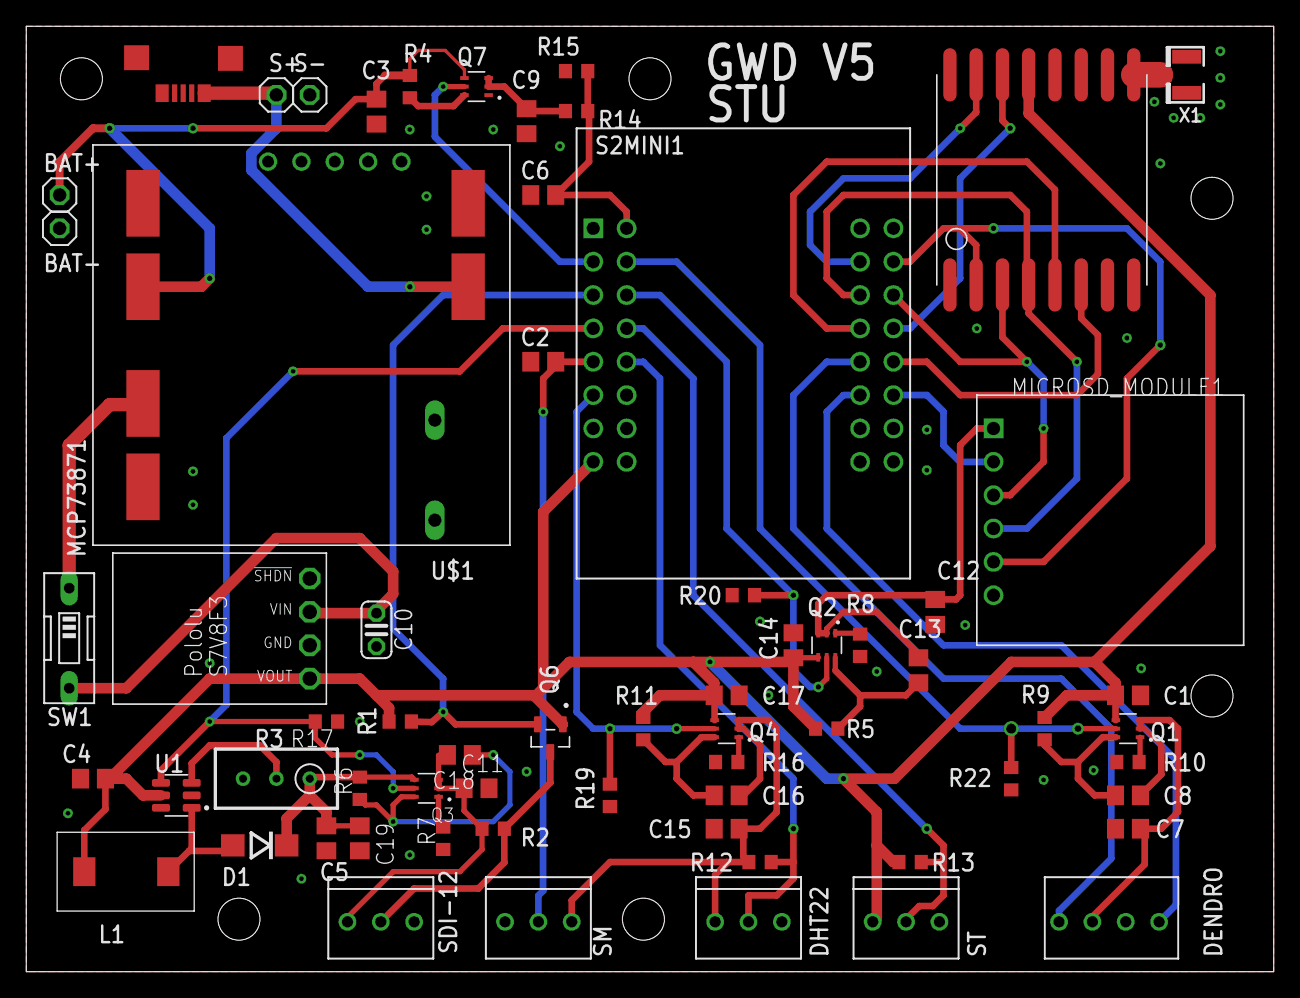
[picture p53: board WiLo V1.0.brd from above]

Board: 2 copper layers, 95.0 x 72.0 mm, 65 parts (0 on the bottom side), 45 nets.
