21941211/WiLo/WiLoV2/WiLoV2 Code/include/DHT22_Driver.h

#include "DHT.h"
#include <debug.h>
#include <config.h>
#include <Arduino.h>
#include "config.h"
#include "MeasureFlags.h"
#include "DataProcessing_Driver.h"
#include "defaultWiLoData.h"


void DHTSetup();
void DHT_Measure();


//extern float tempMedian;
//extern float humMedian;
