21941211/WiLo/WiLoV2/WiLoV2 Code/include/DS18B20_Driver.h

#include <OneWire.h>
#include <DallasTemperature.h>
#include "config.h"
#include "DataProcessing_Driver.h"
#include "MeasureFlags.h"
#include "debug.h"
#include "defaultWiLoData.h"

void readDS18B20();

//extern float DS18B20median;
