21941211/WiLo/WiLoV2/WiLoV2 Code/include/MeasureFlags.h

#include <Arduino.h>
#include "debug.h"

extern uint8_t DHT22_DONE ;
extern uint8_t SM_DONE  ;
extern uint8_t DENDRO_DONE ;
extern uint8_t ST_DONE ;
extern uint8_t SF_DONE ;
extern uint8_t BATT_DONE;
extern uint8_t SDI12_DONE;


extern RTC_DATA_ATTR uint8_t MEASURE_COMPLETE;
