21941211/WiLo/WiLoV2/WiLoV2 Code/src/MeasureFlags.cpp

#include "MeasureFlags.h"

uint8_t DHT22_DONE = 0;
uint8_t SM_DONE = 0;
uint8_t DENDRO_DONE = 0;
uint8_t ST_DONE = 0;
uint8_t SF_DONE = 0;
uint8_t BATT_DONE = 0;
uint8_t SDI12_DONE = 0;

RTC_DATA_ATTR uint8_t MEASURE_COMPLETE = 0;
