21941211/WiLo/(commit log)

2025-04-16 WiLo Parameter file backups
    The files contained herein are text files, required by each WiLo in the IMPACT OAL deployment.
    you will see for each WiLo number (WiLo-xxx) there is a folder containing the LoRa keys. These need to be transferred to the SD card of each WiLo for LoRa integration. Ensure that SD cards are formatted to FAT32: https://www.easeus.com/partition-master/format-64gb-sd-card-to-fat32.html. At the time of publishing, the WiLos already have the necessary parameter files on their respective SD cards.
    [parameters.txt, ttn_devices.csv]
2025-04-16 Inital Source Commit
    [parameters.txt]
2025-04-16 Added More Documentation
    [18_bit_Dendro_V3.csv, 1_1563433200_sampleData.csv, 1_1563436800_sampleData.csv, 2_1563433200_sampleData.csv, 2_1563436800_sampleData.csv, AWN_Data_View_15_Chelan.csv, AWN_Data_View_15_Seattle.csv, BOM.csv]
2025-04-17 Fixed OTA bugs, fixed deep sleep bugs
    [DeepSleep_Driver.cpp, SD_Driver.cpp, main.cpp]
2025-04-29 OTA SoftAP and SF error flags
    [LoRa_Driver.cpp, SD_Driver.cpp, SD_Driver.h, SapFlow_Driver.cpp, main.cpp]
2025-07-03 Updated folder structure
    [BOM_PCBWay_WithSwitch.xlsx, GPIO pinmapping wilov2.ods, Mount.stl, PCB Clip Right Side.stl, PCB_CLip_WiLo_V1 v1.f3d, PCB_Clip v19.f3d, PCB_Mount.FCStd, Power supply and charger module hub bracket.stl]
2025-07-03 Added Eagle source, gerber, BOM and centroid files for WiLoV2
    [BOM for PCBWAY.xlsx, Centroid_Front.csv, PnP_WiLoV4_Added_TPS22917_front.csv, WiLoV2.brd, WiLoV2.sch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]
2025-07-03 Updated DigiDendro, created PCB manufacturing files
    [18_bit_Dendro_V3.csv, BOM_DigiDendro.xlsx, BOM_I2CDENDRO_V3.xlsx, DigiDendro.brd, DigiDendro.csv, DigiDendro.sch, PnP_DigiDendro_front.csv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]
2025-07-07 Updated WiLoV2 source code and PCBWay files
    [Centroid_Front.csv, PnP_WiLoV2_front.csv, bom_output.csv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]
2025-08-04 Added WiLo V2 dcumentation
    [Sensor_LoRa_Adherence.ods, WiLoV2 v2.f3d, WiLoV2.brd, WiLoV2.sch]
2025-11-14 MUX RTC fixes, SDI-12 bug fixes
    [DS18B20_Driver.cpp, DataProcessing_Driver.cpp, I2C_Driver.cpp, I2C_Driver.h, RTC_Driver.cpp, SDI-12_Driver.cpp]
2026-04-23 Added sapflow timer between heatpulse and after heatpulse measurements
2026-05-05 Sapflow Driver Fixes, one-shot measurement mode instead of continuous.
    [SapFlow_Driver.cpp]
2026-05-26 Added longer rise time delay for sapflow measurements, reduced number of samples taken
2026-05-26 Fixed not printing count T2 after to serial
2026-05-29 Fixed some typos in serial debug
    [I2C_Driver.cpp, SapFlow_Driver.cpp]
2026-06-23 Bug fixes for Mux overflow
    [LoRa_Driver.cpp]
