21941211/WiLo/(notices)

Notices in the files:
parts and their libraries:
TPS62175DQCR: COPYRIGHT: Copyright (C) 2025 Ultra Librarian. All rights reserved.
